andriish-hw/esp32-audio-streamer/hardware/bt internet radio receiver mainboard/source switching.png

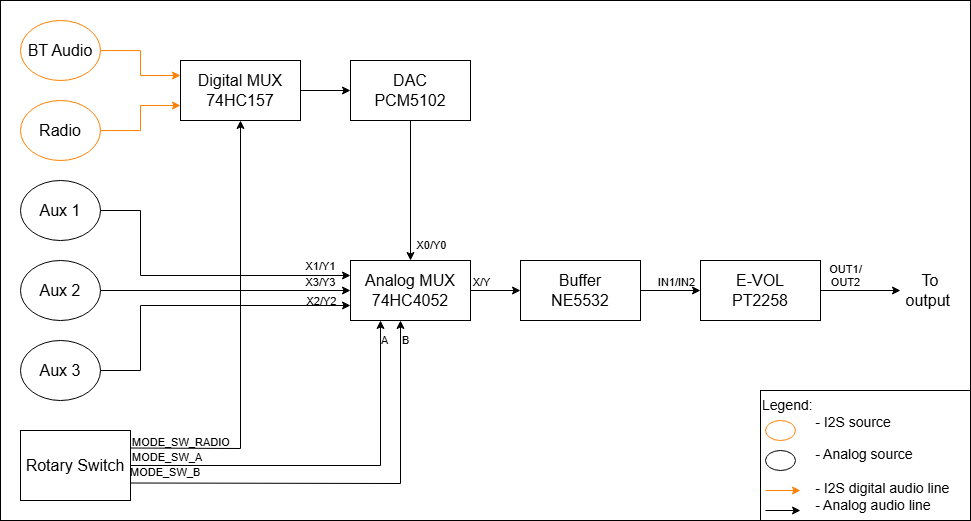
hardware/bt internet radio receiver mainboard/source switching.png
