andriish-hw/esp32-audio-streamer/hardware/bt internet radio receiver audio switch/BOM.xlsx

Reference | Qty | Value | DNP | Exclude from BOM | Exclude from Board | Footprint | Datasheet
*R45,*R46 | 2 | NC | TRUE |  |  | Resistor_SMD:R_0805_2012Metric_Pad1.20x1.40mm_HandSolder | ~
C1,C2,C3,C4,C5,C6,C7,C8 | 8 | 220p | TRUE |  |  | Capacitor_SMD:C_0805_2012Metric_Pad1.18x1.45mm_HandSolder | ~
C9,C10,C20,C21,C22,C23,C25,C26,C33,C42,C43 | 11 | 100n | FALSE |  |  | Capacitor_SMD:C_0805_2012Metric_Pad1.18x1.45mm_HandSolder | ~
C11,C12,C18,C19 | 4 | 100u | FALSE |  |  | Capacitor_THT:CP_Radial_D6.3mm_P2.50mm | ~
C15,C16 | 2 | 150p | TRUE |  |  | Capacitor_SMD:C_0805_2012Metric_Pad1.18x1.45mm_HandSolder | ~
C17,C24 | 2 | 10u | FALSE |  |  | Capacitor_SMD:C_1206_3216Metric_Pad1.33x1.80mm_HandSolder | ~
C27,C28,C29,C30,C31,C32,C34,C35,C36,C37,C38,C39,C40,C41 | 14 | 10u | FALSE |  |  | Capacitor_THT:CP_Radial_D5.0mm_P2.00mm | ~
D1,D2 | 2 | 1N4148 | FALSE |  |  | Diode_SMD:D_SOD-323_HandSoldering | https://assets.nexperia.com/documents/data-sheet/1N4148_1N4448.pdf
D3 | 1 | BZV55C4V3 | TRUE |  |  | Diode_SMD:D_MiniMELF | https://assets.nexperia.com/documents/data-sheet/BZV55_SER.pdf
J1,J4,J7,J9 | 4 | Conn_01x03_Pin | FALSE |  |  | Connector_PinHeader_2.54mm:PinHeader_1x03_P2.54mm_Vertical | ~
J2,J3 | 2 | Conn_Coaxial_x4_Isolated_by_pairs | FALSE |  |  | Connector:KLS1-RCA-410
J5 | 1 | Conn_01x04_Pin | FALSE |  |  | Connector_PinHeader_2.54mm:PinHeader_1x04_P2.54mm_Vertical | ~
J6 | 1 | Conn_01x06_Pin | FALSE |  |  | Connector_PinHeader_2.54mm:PinHeader_1x06_P2.54mm_Vertical | ~
J8,J10 | 2 | Conn_01x05_Pin | FALSE |  |  | Connector_PinHeader_2.54mm:PinHeader_1x05_P2.54mm_Vertical | ~
R1,R19,R20,R44,R45,R47 | 6 | 0 | TRUE |  |  | Resistor_SMD:R_0805_2012Metric_Pad1.20x1.40mm_HandSolder | ~
R2,R46 | 2 | 0 | TRUE |  |  | Resistor_SMD:R_1206_3216Metric_Pad1.30x1.75mm_HandSolder | ~
R3,R4,R7,R8,R11,R12,R15,R16 | 8 | 470 | TRUE |  |  | Resistor_SMD:R_0805_2012Metric_Pad1.20x1.40mm_HandSolder | ~
R5,R6,R9,R10,R13,R14 | 6 | 47k | TRUE |  |  | Resistor_SMD:R_0805_2012Metric_Pad1.20x1.40mm_HandSolder | ~
R17,R18 | 2 | 2.2k | FALSE |  |  | Resistor_SMD:R_0805_2012Metric_Pad1.20x1.40mm_HandSolder | ~
R21,R22,R23,R24,R25,R26,R30,R31,R34,R35,R36,R37,R38,R39 | 14 | 100k | FALSE |  |  | Resistor_SMD:R_0805_2012Metric_Pad1.20x1.40mm_HandSolder | ~
R27,R28 | 2 | 1k | FALSE |  |  | Resistor_SMD:R_0805_2012Metric_Pad1.20x1.40mm_HandSolder | ~
R29 | 1 | 470 | TRUE |  |  | Resistor_SMD:R_1206_3216Metric_Pad1.30x1.75mm_HandSolder | ~
R32,R33 | 2 | 51k | FALSE |  |  | Resistor_SMD:R_0805_2012Metric_Pad1.20x1.40mm_HandSolder | ~
R40,R41 | 2 | 100 | TRUE |  |  | Resistor_SMD:R_0805_2012Metric_Pad1.20x1.40mm_HandSolder | ~
R42,R43 | 2 | 10k | TRUE |  |  | Resistor_SMD:R_0805_2012Metric_Pad1.20x1.40mm_HandSolder | ~
RV1,RV2 | 2 | 47k | FALSE |  |  | Potentiometer_THT:Potentiometer_Runtron_RM-065_Vertical | ~
RV3,RV4 | 2 | 200k | FALSE |  |  | Potentiometer_THT:Potentiometer_Runtron_RM-065_Vertical | ~
U1 | 1 | CD4052B | TRUE |  |  | Package_SO:SOIC-16_3.9x9.9mm_P1.27mm | http://www.ti.com/lit/ds/symlink/cd4052b.pdf
U2,U5,U6 | 3 | NE5532 | FALSE |  |  | Package_DIP:DIP-8_W7.62mm_Socket_LongPads | http://www.ti.com/lit/ds/symlink/ne5532.pdf
U3 | 1 | ISO1540 | FALSE |  |  | Package_SO:SOIC-8_3.9x4.9mm_P1.27mm | http://www.ti.com/lit/ds/symlink/iso1541.pdf
U4 | 1 | PT2258-S | FALSE |  |  | Package_SO:SO-20_12.8x7.5mm_P1.27mm | http://www.princeton.com.tw/Portals/0/Product/PT2258-s.pdf
U7 | 1 | L78L09_TO92 | FALSE |  |  | Package_TO_SOT_THT:TO-92_Inline_Wide | http://www.st.com/content/ccc/resource/technical/document/datasheet/15/55/e5/aa/23/5b/43/fd/CD00000446.pdf/files/CD00000446.pdf/jcr:content/translations/en.CD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
 | 114
 | 41 | 35.96%
