andriish-hw/esp32-audio-streamer/hardware/bt internet radio receiver mainboard/bt internet radio receiver mainboard.pdf

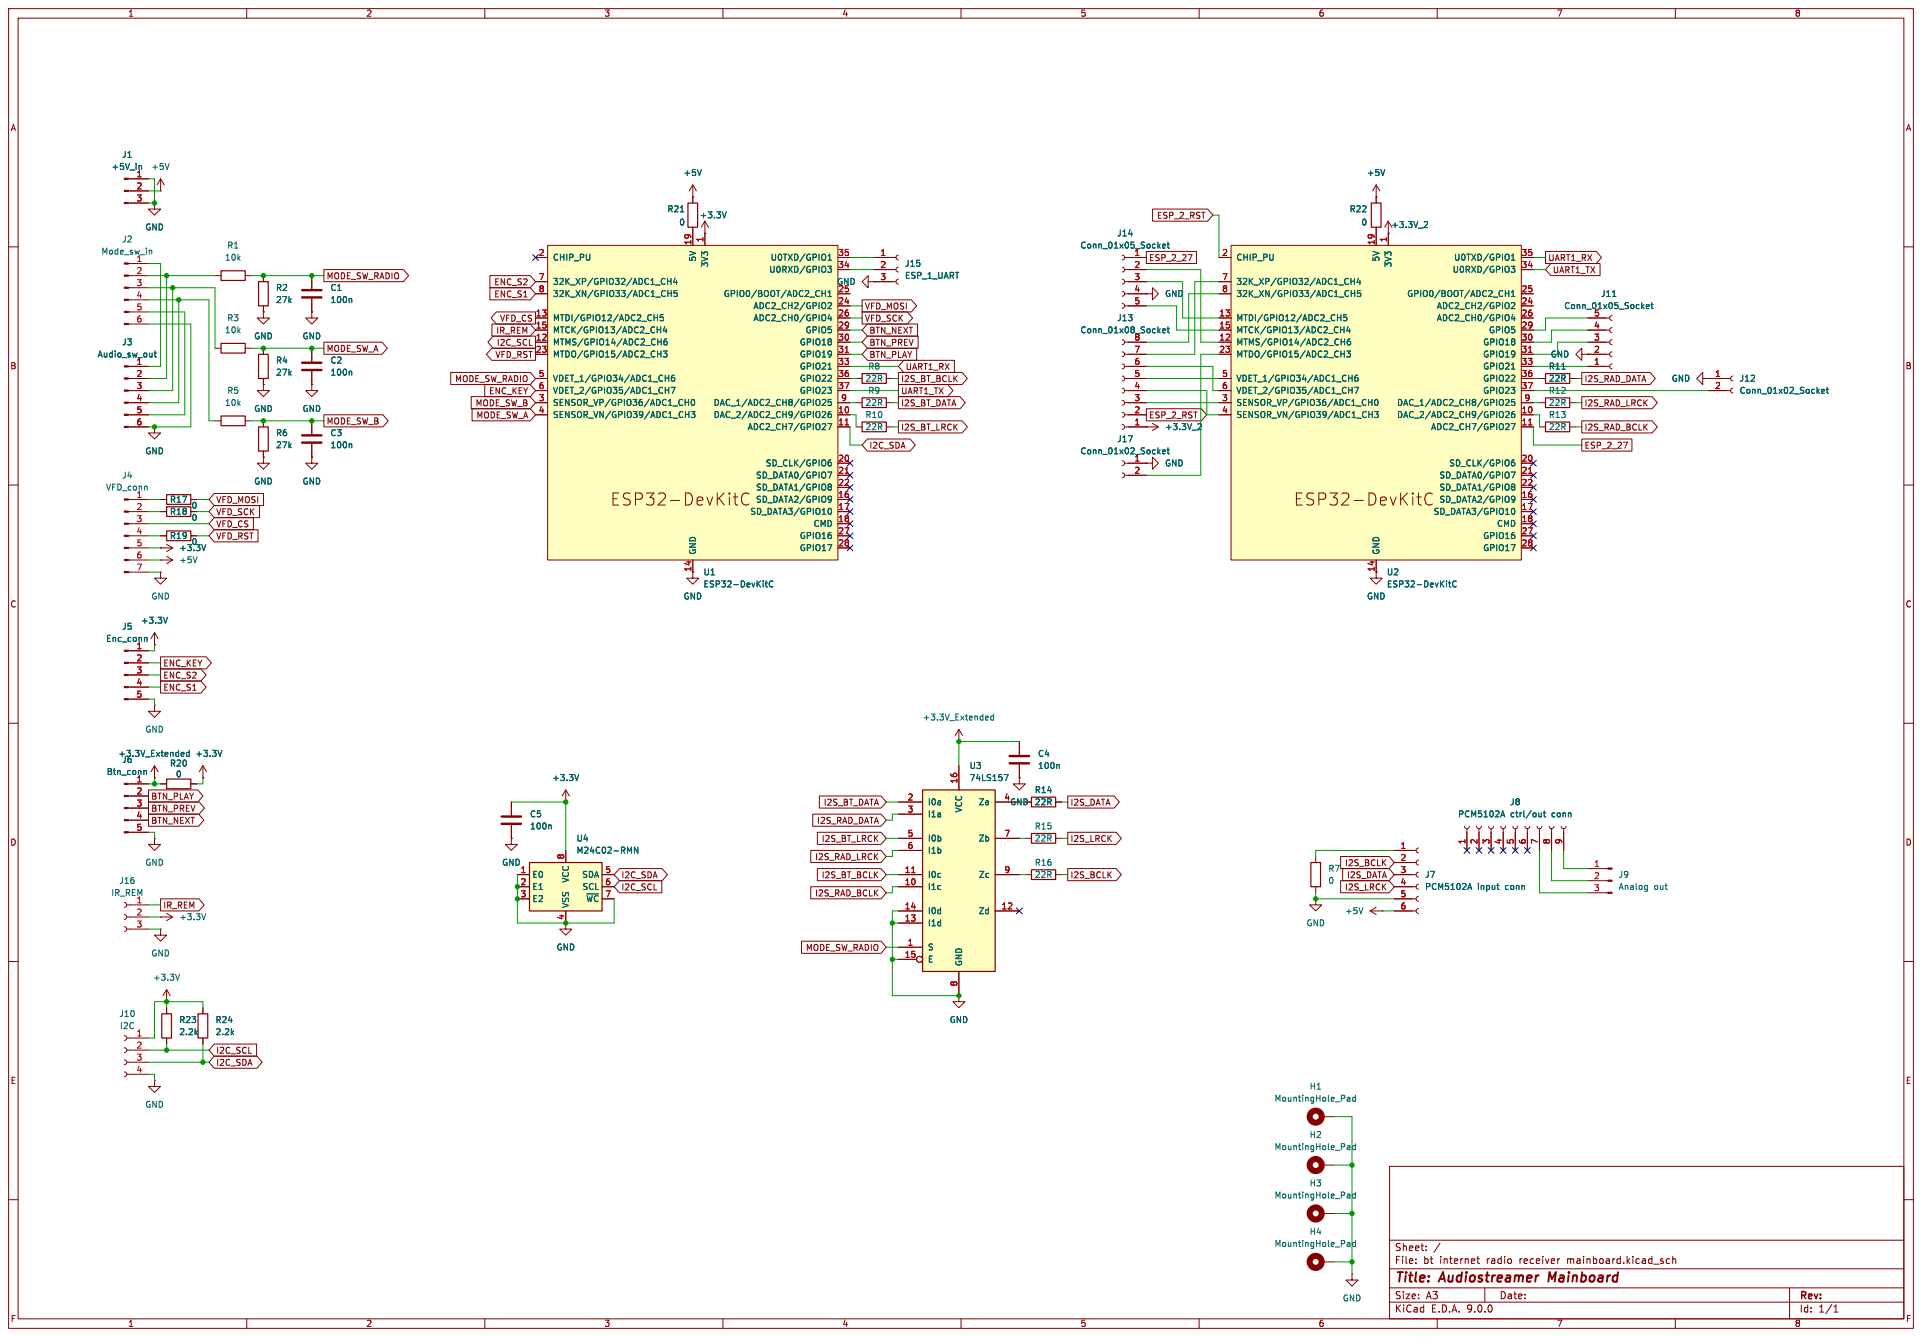
[picture p2: page 1]

4 SDA 5 SCL 6 ~{WC}7 U4 M24C02-RMN GND GND

8 Za 4 Zb 7 Zc 9 Zd 12 GND

Id: 1/1 Title: Audiostreamer Mainboard
