andriish-hw/esp32-audio-streamer/hardware/bt internet radio receiver source rotary switch board/bt internet radio receiver source rotary switch board.pdf

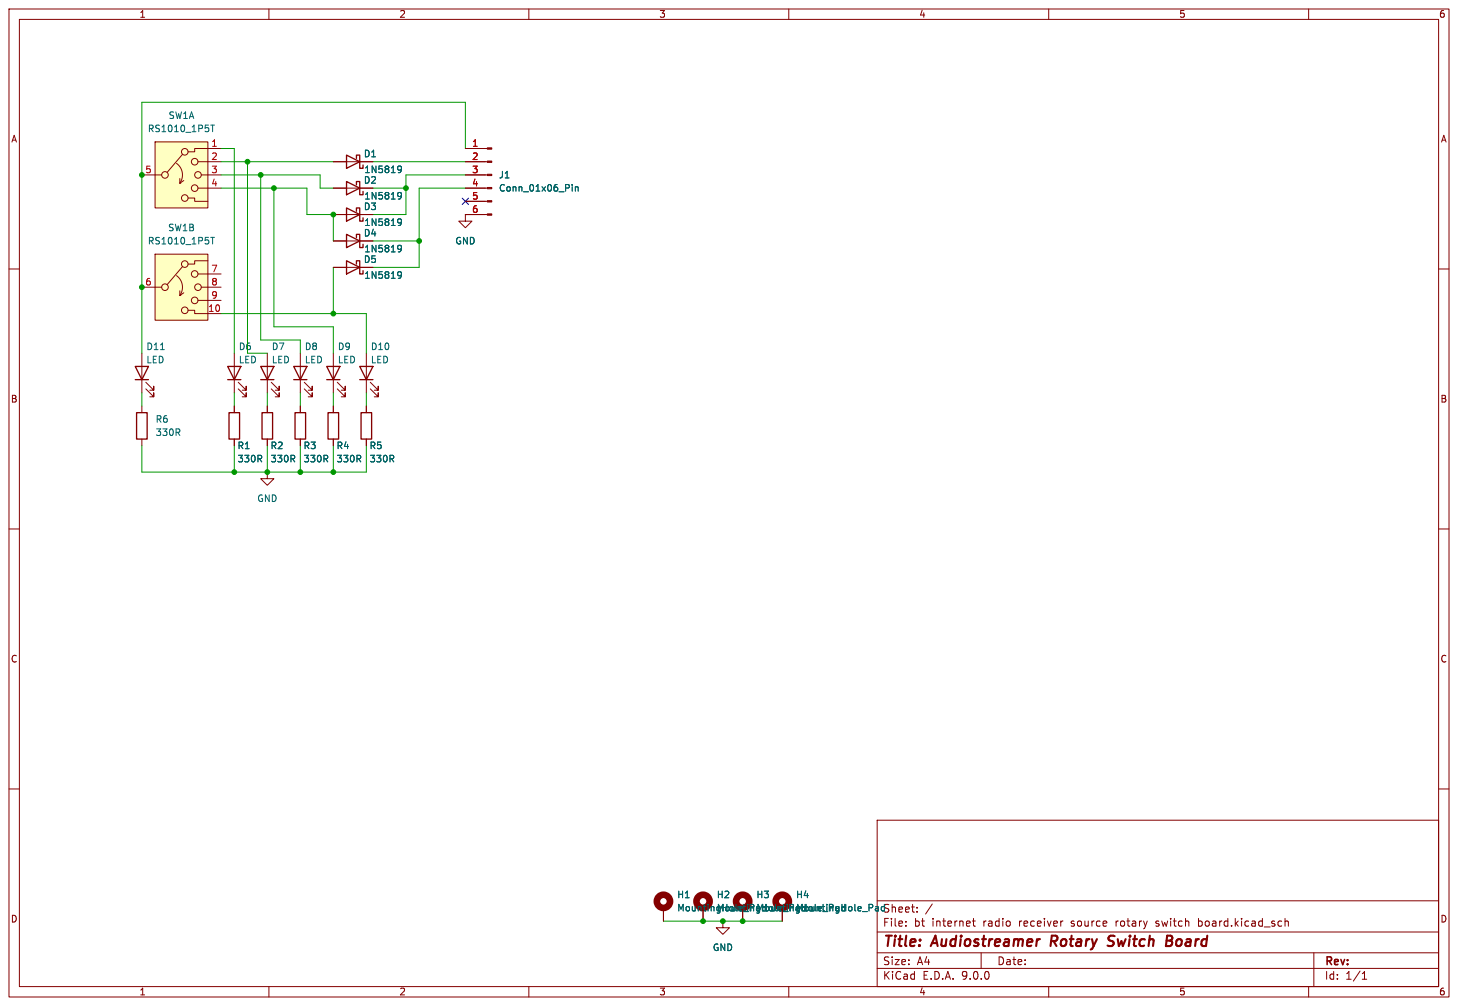
[picture p3: page 1]

Id: 1/1 Title: Audiostreamer Rotary Switch Board
