andriish-hw/esp32-audio-streamer/hardware/opamp headphones amp with discrete transistors/opamp headphones amp with discrete transistors.pdf

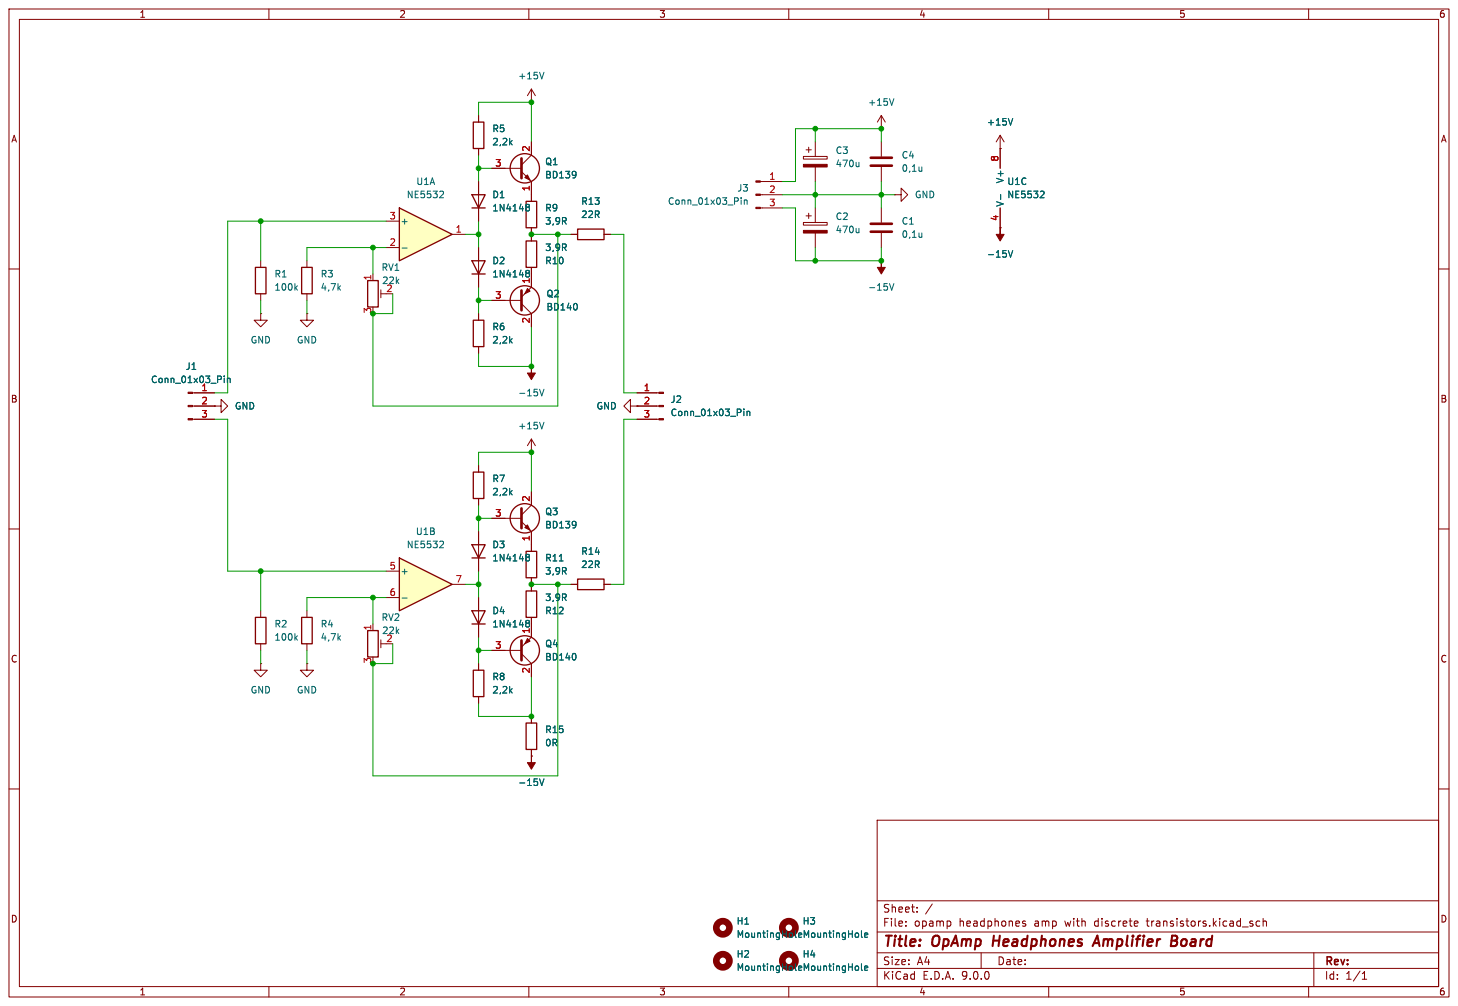
[picture p4: page 1]

H2 MountingHole H4 MountingHole H1 MountingHole H3 MountingHole

Id: 1/1 Title: OpAmp Headphones Amplifier Board
