andriish-hw/esp32-audio-streamer/hardware/VU meter PP4/VU meter PP4.pdf

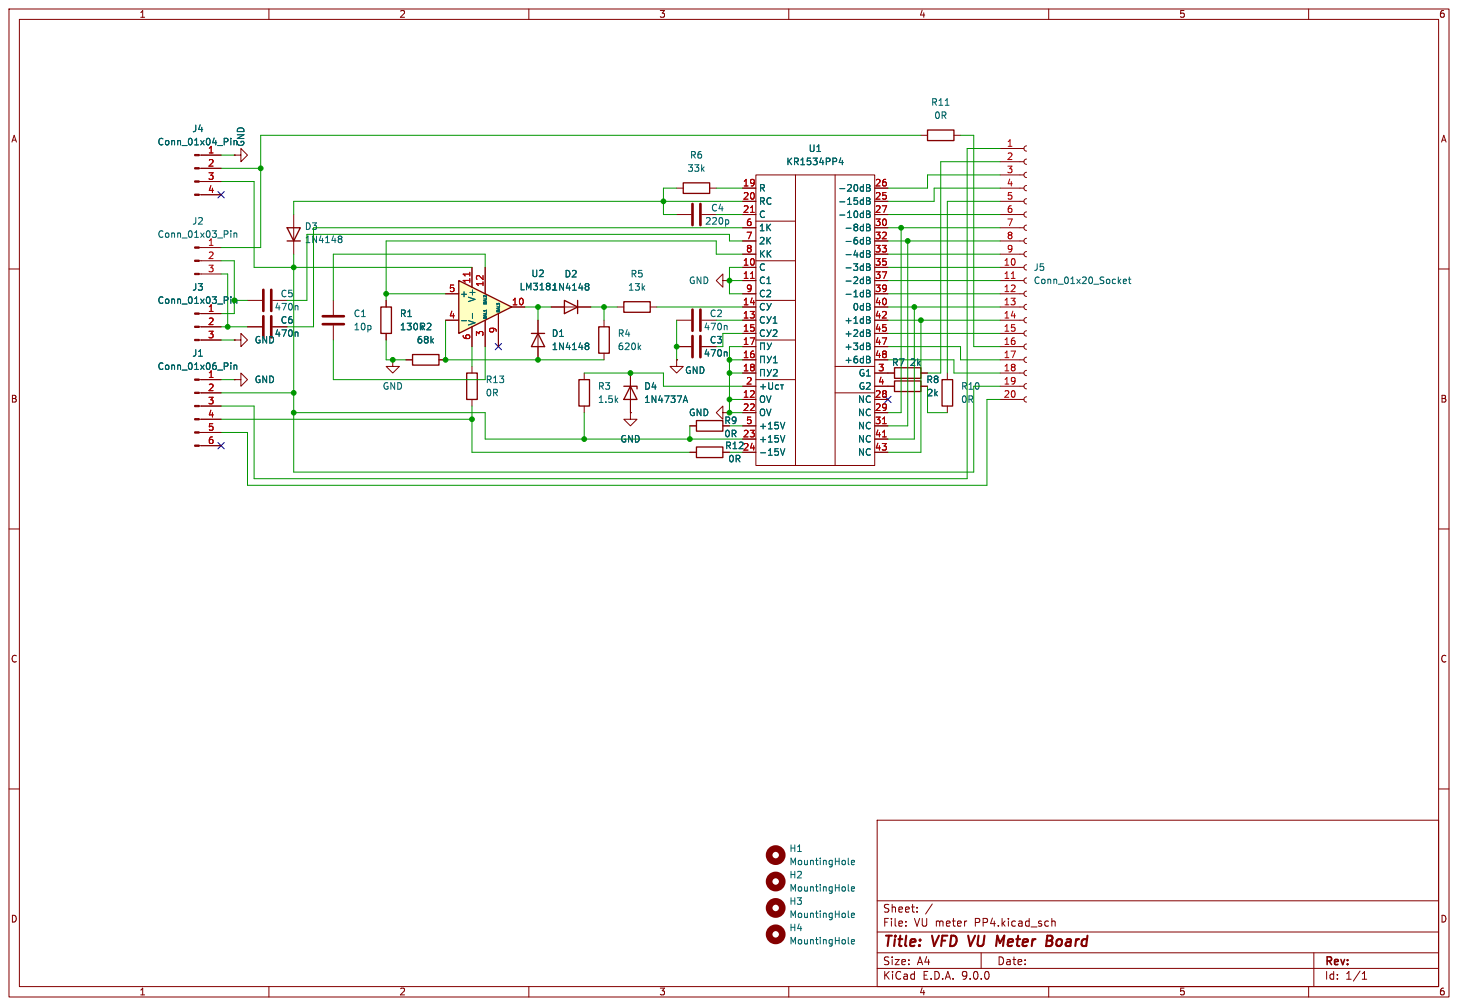
[picture p5: page 1]

H1 MountingHole H4 MountingHole H2 MountingHole H3 MountingHole

Id: 1/1 Title: VFD VU Meter Board
