andriish-hw/esp32-audio-streamer/hardware/bt internet radio receiver audio switch/bt internet radio receiver audio switch.pdf

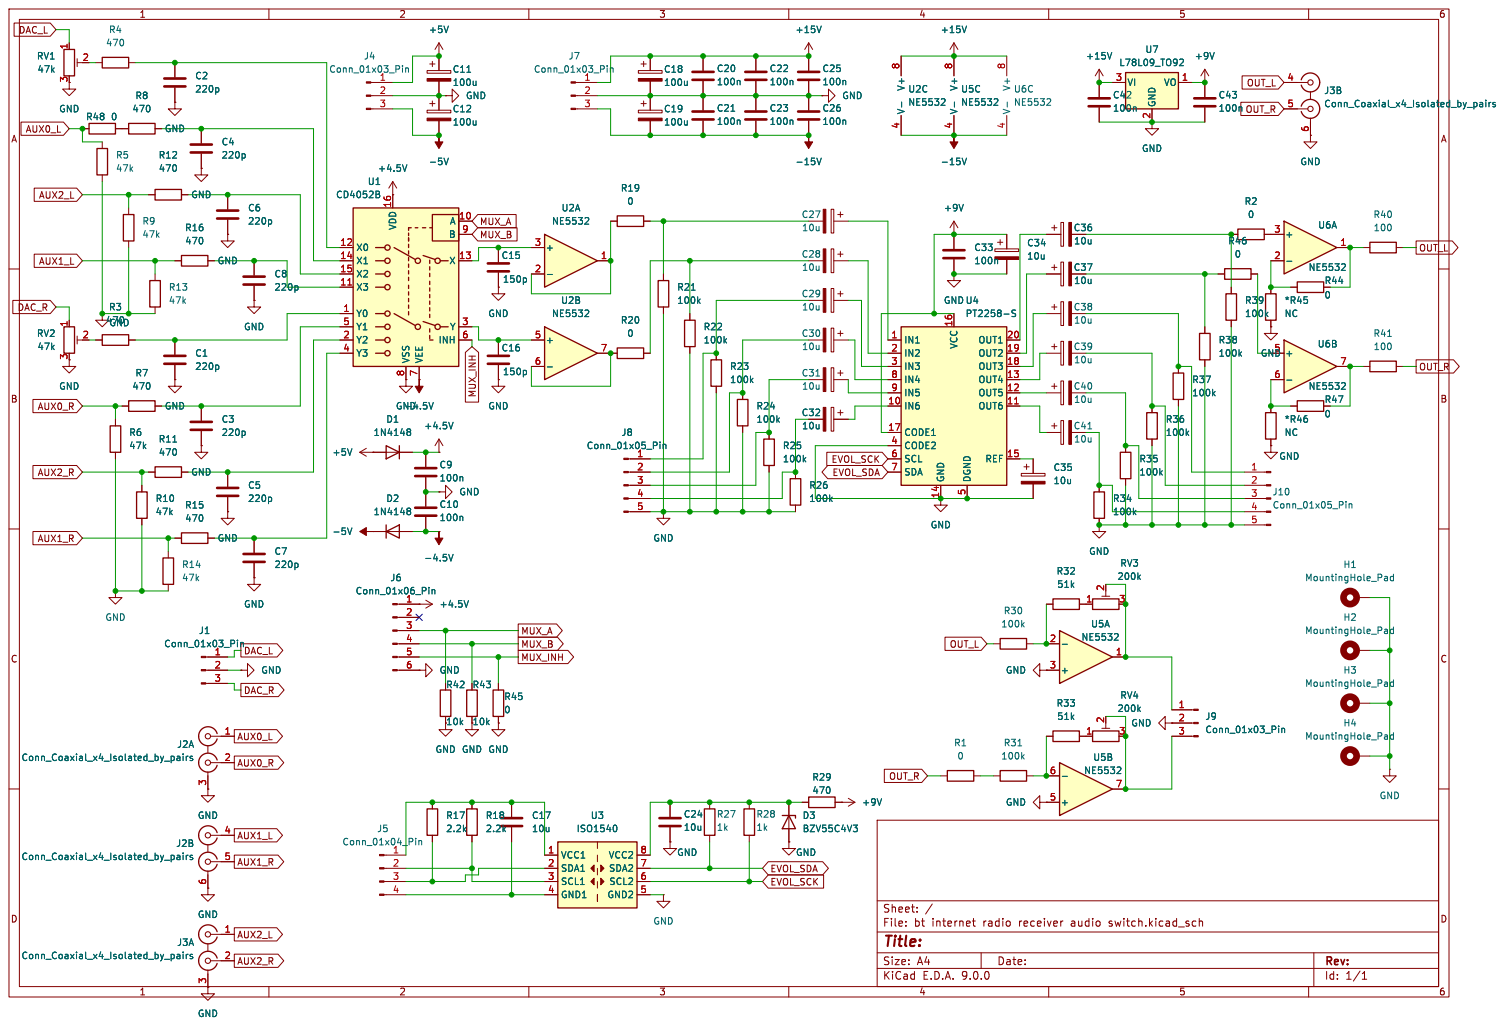
[picture p6: page 1]
