andriish-hw/esp32-audio-streamer/hardware/bt internet radio receiver button board/bt internet radio receiver button board.pdf

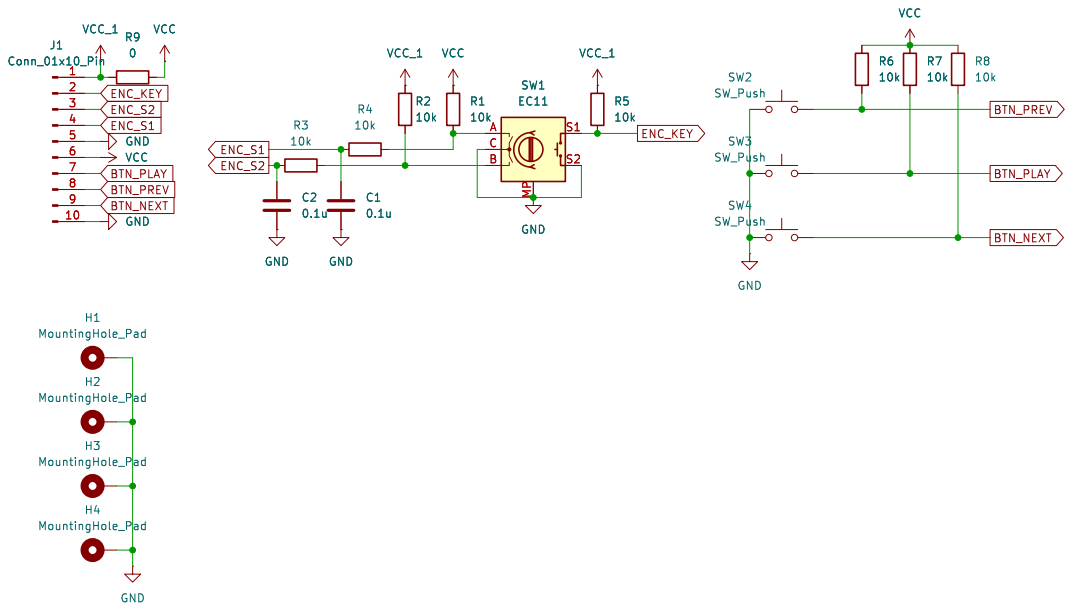
[picture p7: page 1]
