andriish-hw/esp32-audio-streamer/hardware/bt internet radio receiver psu/bt internet radio receiver psu.pdf

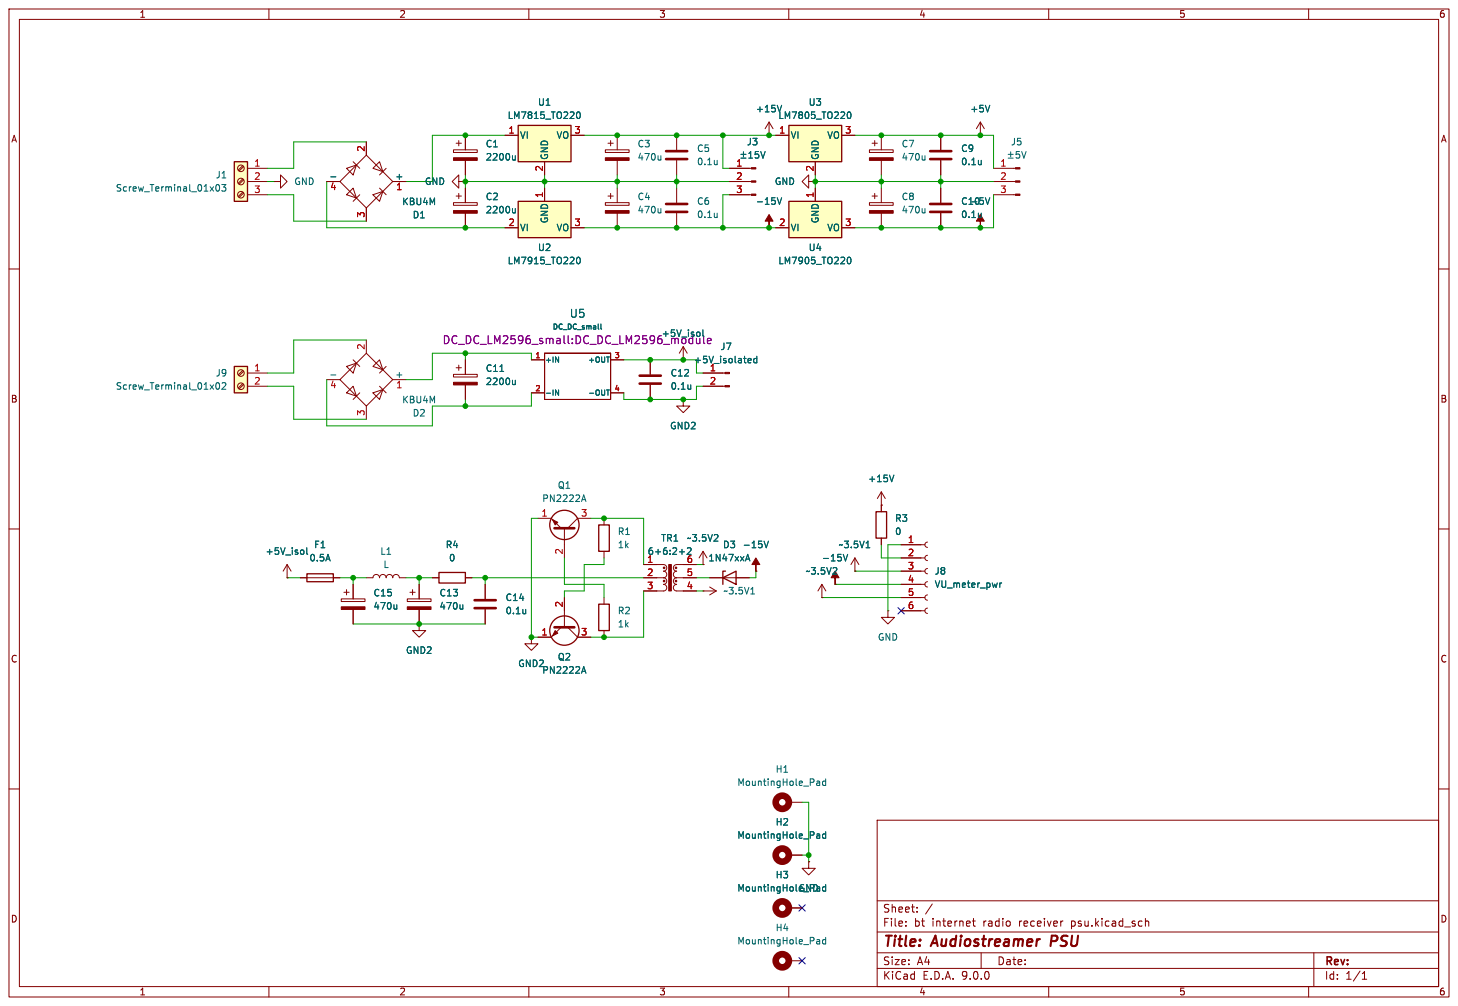
[picture p8: page 1]

Id: 1/1 Title: Audiostreamer PSU
