andriish-hw/esp32-audio-streamer/hardware/bt internet radio receiver audio switch/b.cu.pdf

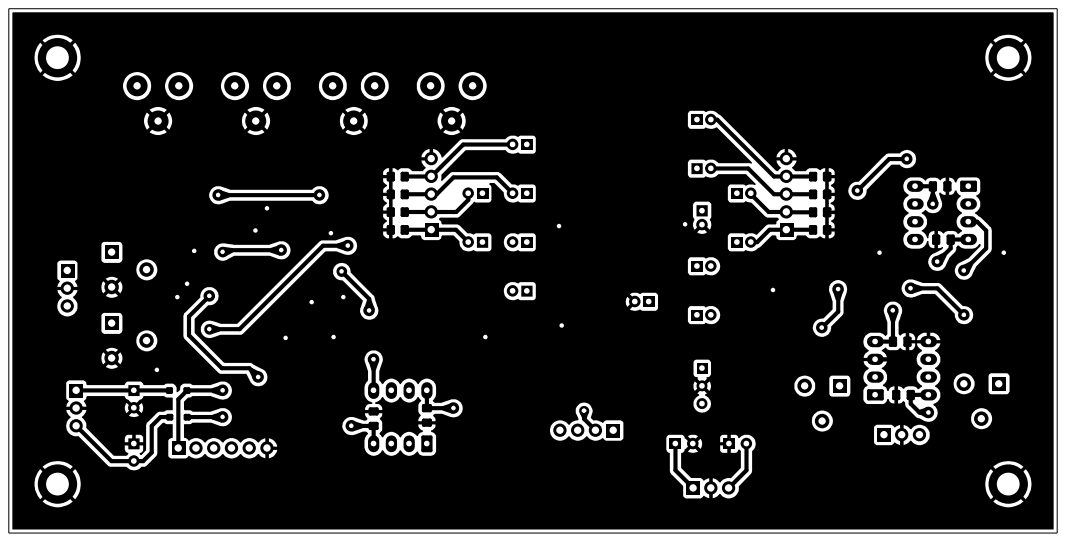
[picture p9: page 1]
