andriish-hw/esp32-audio-streamer/hardware/bt internet radio receiver audio switch/f.cu.pdf

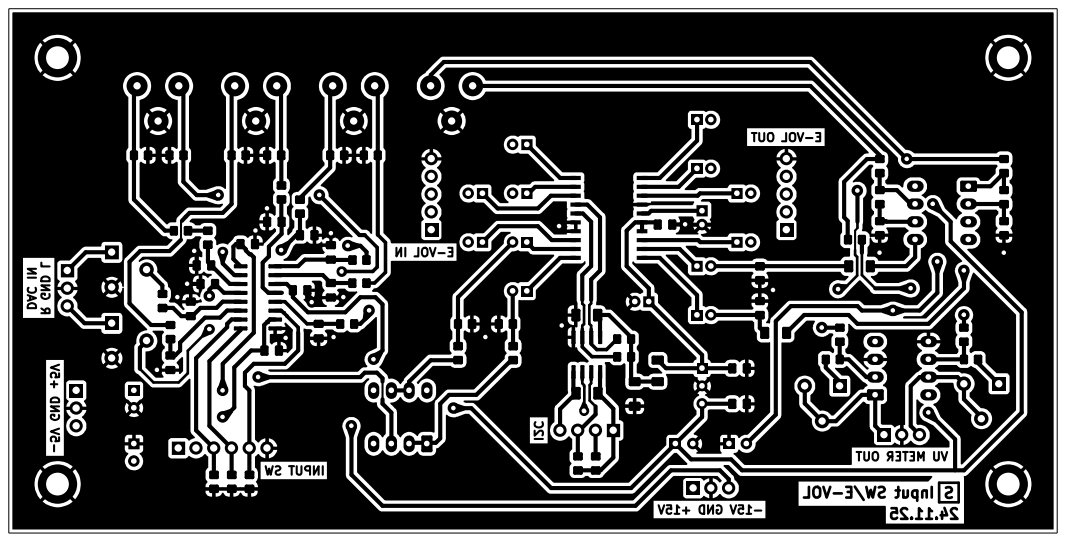
[picture p10: page 1]
