andriish-hw/esp32-audio-streamer/hardware/opamp headphones amp with discrete transistors/opamp headphones amp with discrete transistors 84x60.pdf

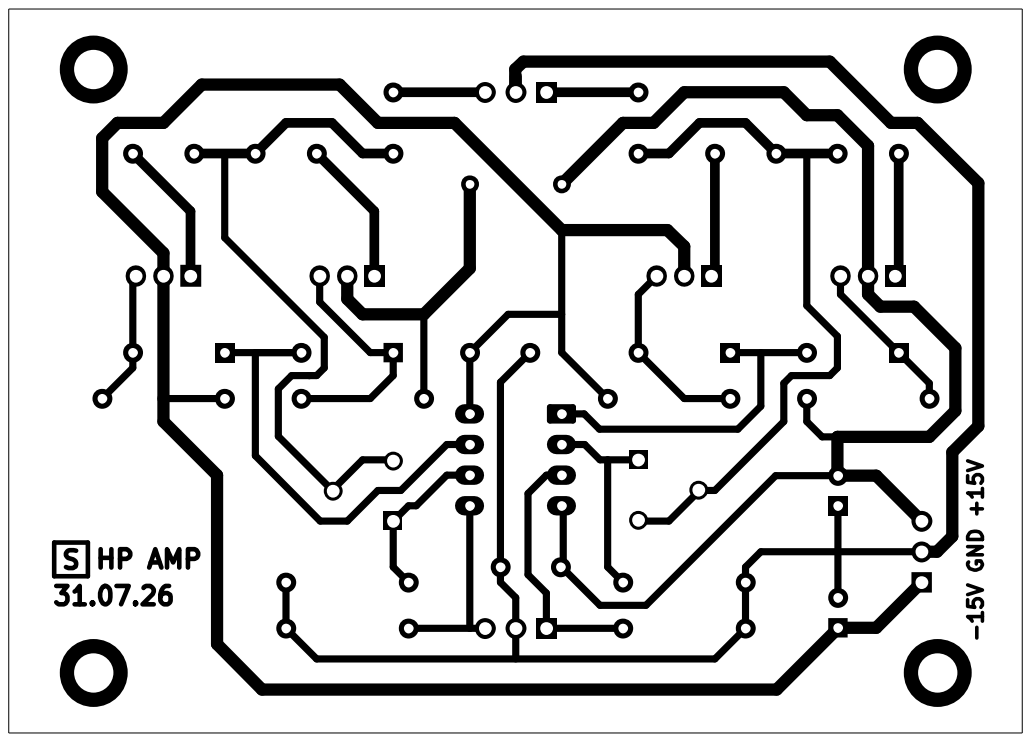
[picture p11: page 1]
