andriish-hw/esp32-audio-streamer/hardware/opamp headphones amp with discrete transistors/дзерк_opamp headphones amp with discrete transistors 84x60.pdf

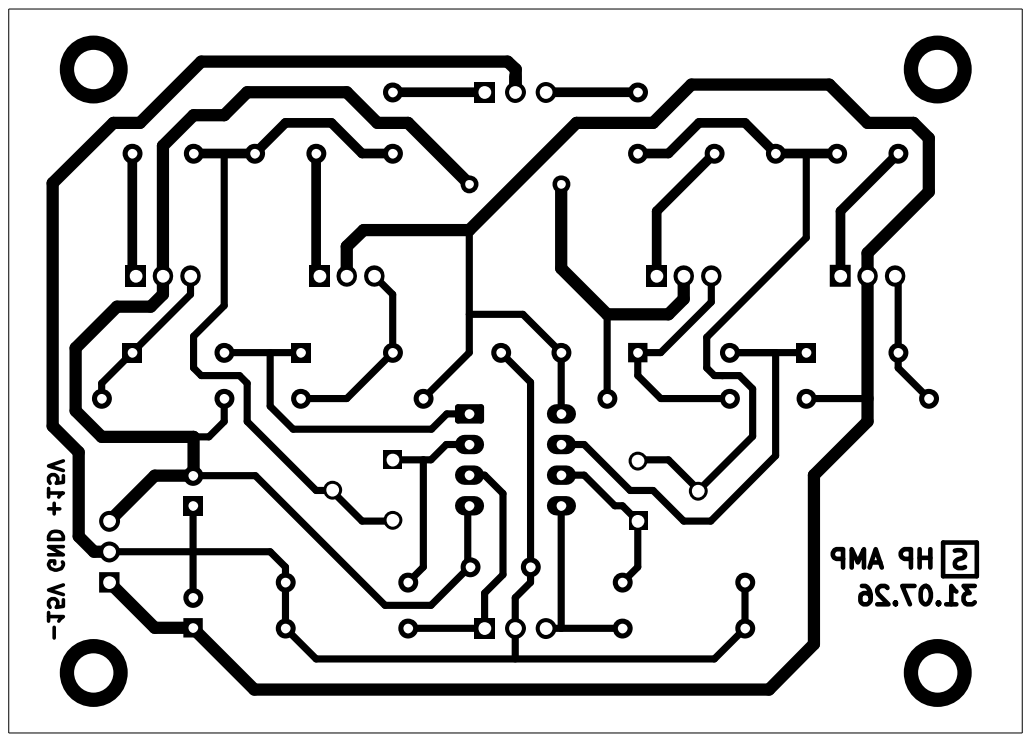
[picture p12: page 1]
