andriish-hw/esp32-audio-streamer/hardware/VU meter PP4/VU meter PP4 100x74.pdf

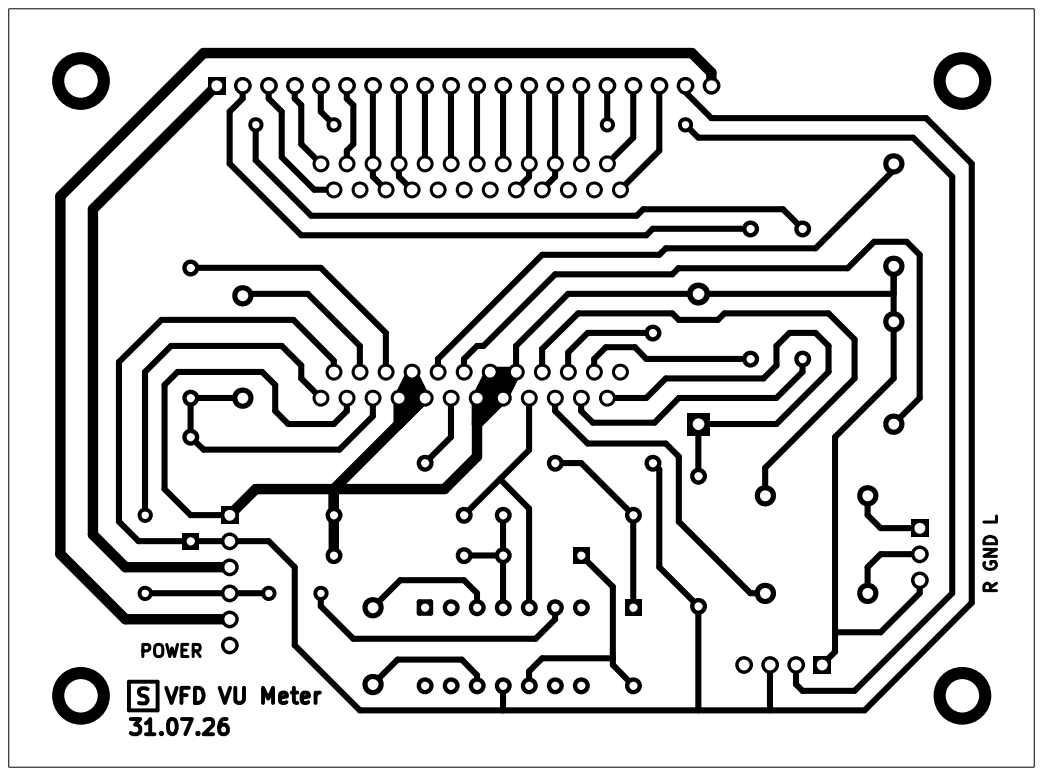
[picture p13: page 1]
