andriish-hw/esp32-audio-streamer/hardware/VU meter PP4/дзерк_VU meter PP4 100x74.pdf

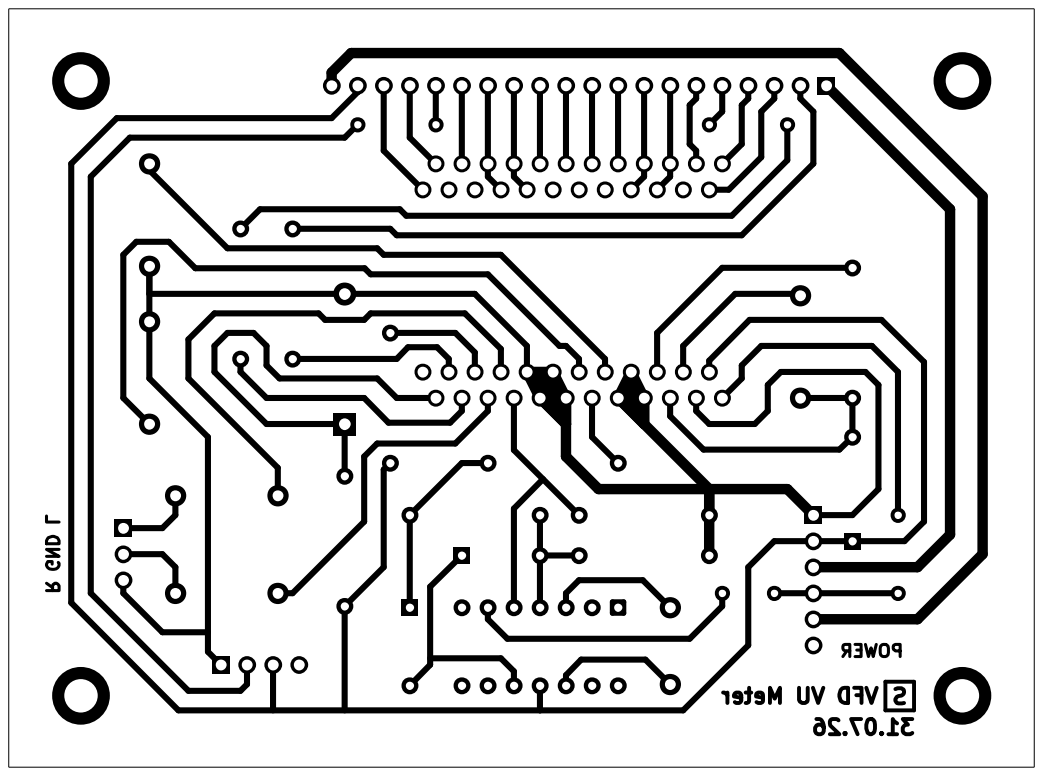
[picture p14: page 1]
