andriish-hw/esp32-audio-streamer/(list of files, drawings)

Other design files:
hardware/bt internet radio receiver audio switch/freerouting.dsn
hardware/bt internet radio receiver audio switch/temp-freerouting.dsn
