andriish-hw/esp32-audio-streamer/hardware/bt internet radio receiver audio switch/bt internet radio receiver audio switch.kicad_pcb

## KiCad design hardware/bt internet radio receiver audio switch/bt internet radio receiver audio switch.kicad_pcb (2026-08-18)

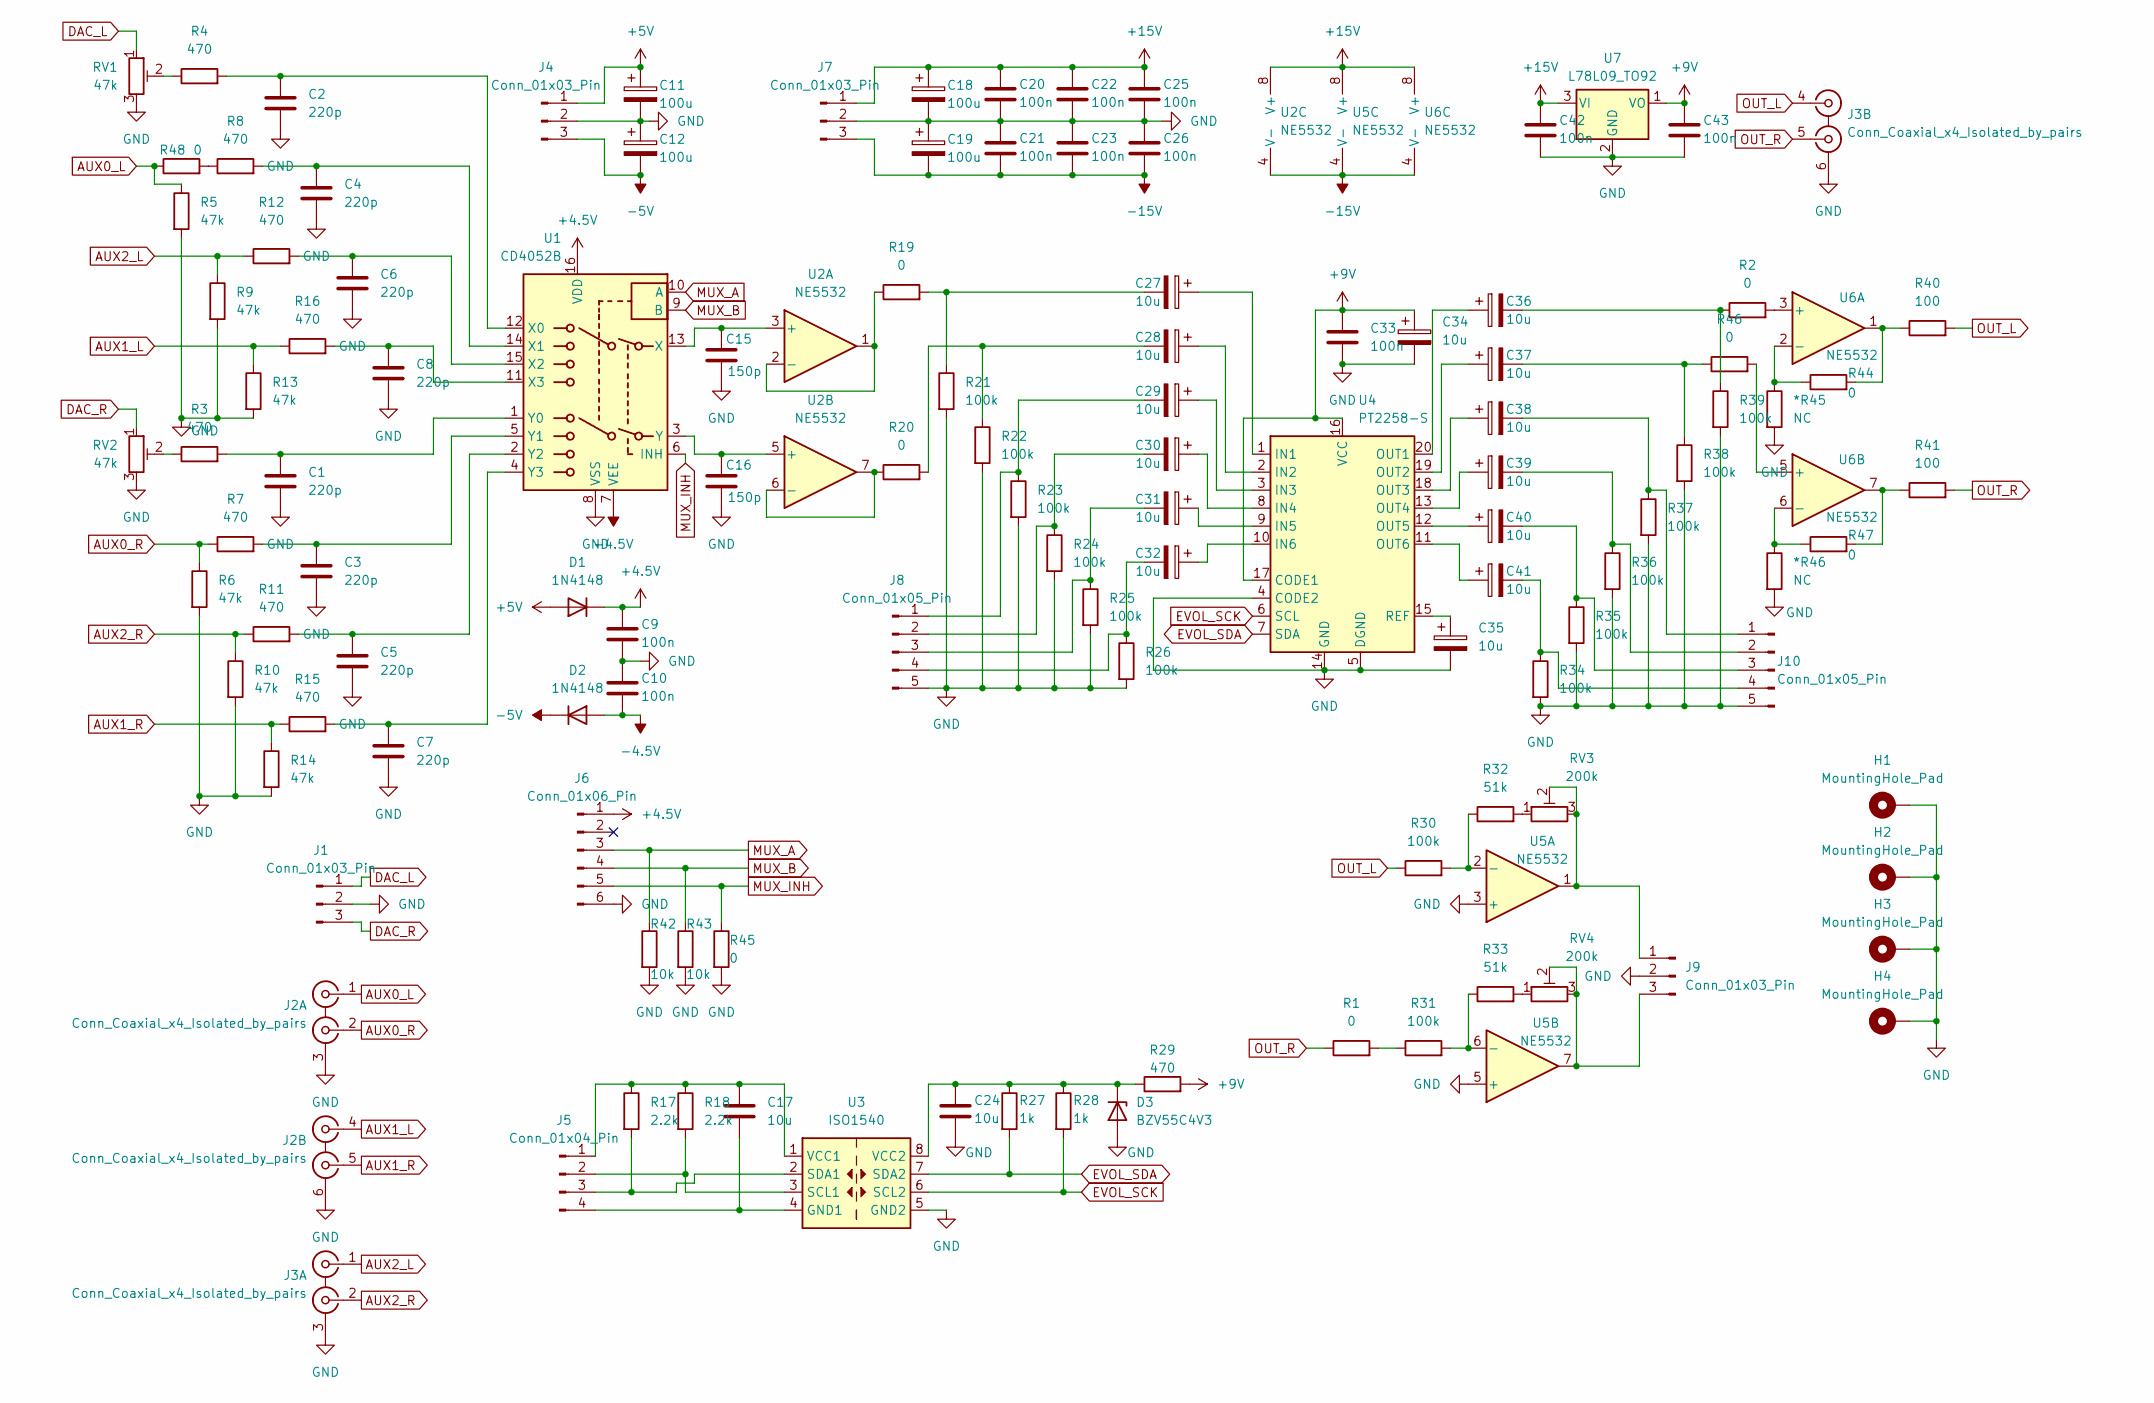
[picture p15: schematic bt internet radio receiver audio switch.kicad_sch]

Parts:
*R45, *R46: NC; R_0805_2012Metric_Pad1.20x1.40mm_HandSolder
C1, C2, C3, C4, C5, C6, C7, C8: 220p; C_0805_2012Metric_Pad1.18x1.45mm_HandSolder
C9, C10, C20, C21, C22, C23, C25, C26, C33, C42, C43: 100n; C_0805_2012Metric_Pad1.18x1.45mm_HandSolder
C11, C12, C18, C19: 100u; CP_Radial_D6.3mm_P2.50mm
C15, C16: 150p; C_0805_2012Metric_Pad1.18x1.45mm_HandSolder
C17, C24: 10u; C_1206_3216Metric_Pad1.33x1.80mm_HandSolder
C27, C28, C29, C30, C31, C32, C34, C35, C36, C37, C38, C39, C40, C41: 10u; CP_Radial_D5.0mm_P2.00mm
D1, D2: 1N4148; D_SOD-323_HandSoldering
D3: BZV55C4V3; D_MiniMELF
H1, H2, H3, H4: MountingHole_Pad; MountingHole_3.2mm_M3_DIN965_Pad_TopBottom
J1, J4, J7, J9: Conn_01x03_Pin; PinHeader_1x03_P2.54mm_Vertical
J2, J3: Conn_Coaxial_x4_Isolated_by_pairs; KLS1-RCA-410
J5: Conn_01x04_Pin; PinHeader_1x04_P2.54mm_Vertical
J6: Conn_01x06_Pin; PinHeader_1x06_P2.54mm_Vertical
J8, J10: Conn_01x05_Pin; PinHeader_1x05_P2.54mm_Vertical
R1, R19, R20, R44, R45, R47, R48: 0; R_0805_2012Metric_Pad1.20x1.40mm_HandSolder
R2, R46: 0; R_1206_3216Metric_Pad1.30x1.75mm_HandSolder
R3, R4, R7, R8, R11, R12, R15, R16: 470; R_0805_2012Metric_Pad1.20x1.40mm_HandSolder
R5, R6, R9, R10, R13, R14: 47k; R_0805_2012Metric_Pad1.20x1.40mm_HandSolder
R17, R18: 2.2k; R_0805_2012Metric_Pad1.20x1.40mm_HandSolder
R21, R22, R23, R24, R25, R26, R30, R31, R34, R35, R36, R37, R38, R39: 100k; R_0805_2012Metric_Pad1.20x1.40mm_HandSolder
R27, R28: 1k; R_0805_2012Metric_Pad1.20x1.40mm_HandSolder
R29: 470; R_1206_3216Metric_Pad1.30x1.75mm_HandSolder
R32, R33: 51k; R_0805_2012Metric_Pad1.20x1.40mm_HandSolder
R40, R41: 100; R_0805_2012Metric_Pad1.20x1.40mm_HandSolder
R42, R43: 10k; R_0805_2012Metric_Pad1.20x1.40mm_HandSolder
RV1, RV2: 47k; Potentiometer_Runtron_RM-065_Vertical
RV3, RV4: 200k; Potentiometer_Runtron_RM-065_Vertical
U1: CD4052B; SOIC-16_3.9x9.9mm_P1.27mm
U2, U5, U6: NE5532; DIP-8_W7.62mm_Socket_LongPads
U3: ISO1540; SOIC-8_3.9x4.9mm_P1.27mm
U4: PT2258-S; SO-20_12.8x7.5mm_P1.27mm
U7: L78L09_TO92; TO-92_Inline_Wide

Connections:
+4.5V: C9.1, D1.1 (K), J6.1, U1.16 (VDD)
+5V: C11.1, D1.2 (A), J4.1
+9V: C33.1, C34.1, C43.1, R29.2, U4.16 (VCC), U4.17 (CODE1), U7.1 (VO)
+15V: C18.1, C20.1, C22.1, C25.1, C42.1, J7.1, U2.8 (V+), U5.8 (V+), U6.8 (V+), U7.3 (VI)
-4.5V: C10.2, D2.2 (A), U1.7 (VEE)
-5V: C12.2, D2.1 (K), J4.3
-15V: C19.2, C21.2, C23.2, C26.2, J7.3, U2.4 (V-), U5.4 (V-), U6.4 (V-)
AUX0_L: J2.1 (IN1), R5.1, R48.1
AUX0_R: J2.2 (IN2), R6.1, R7.1
AUX1_L: J2.4 (IN1), R13.1, R16.1
AUX1_R: J2.5 (IN2), R14.1, R15.1
AUX2_L: J3.1 (IN1), R9.1, R12.1
AUX2_R: J3.2 (IN2), R10.1, R11.1
DAC_L: J1.1, RV1.1
DAC_R: J1.3, RV2.1
EVOL_SCK: R28.2, U3.6 (SCL2), U4.6 (SCL)
EVOL_SDA: R27.2, U3.7 (SDA2), U4.7 (SDA)
GND: *R45.2, *R46.2, C1.2, C2.2, C3.2, C4.2, C5.2, C6.2, C7.2, C8.2, C9.2, C10.1, C11.2, C12.1, C15.2, C16.2, C18.2, C19.1, C20.2, C21.1, C22.2, C23.1, C24.2, C25.2, C26.1, C33.2, C34.2, C35.2, C42.2, C43.2, D3.2 (A), H1.1, H2.1, H3.1, H4.1, J1.2, J2.3 (EXT), J2.6 (EXT), J3.3 (EXT), J3.6 (EXT), J4.2, J6.6, J7.2, J8.5, J9.2, J10.5, R5.2, R6.2, R9.2, R10.2, R13.2, R14.2, R21.2, R22.2, R23.2, R24.2, R25.2, R26.2, R34.2, R35.2, R36.2, R37.2, R38.2, R39.2, R42.2, R43.2, R45.2, RV1.3, RV2.3, U1.8 (VSS), U3.5 (GND2), U4.4 (CODE2), U4.5 (DGND), U4.14 (GND), U5.3 (+), U5.5 (+), U7.2 (GND)
MUX_A: J6.3, R42.1, U1.10 (A)
MUX_B: J6.4, R43.1, U1.9 (B)
MUX_INH: J6.5, R45.1, U1.6 (INH)
unnamed: C27.2, R19.2, R21.1
unnamed: C28.2, R20.2, R22.1
unnamed: C36.2, R2.1, R39.1
unnamed: C37.2, R38.1, R46.1
unnamed: C24.1, D3.1 (K), R27.1, R28.1, R29.1, U3.8 (VCC2)
unnamed: C17.1, J5.1, R17.1, R18.1, U3.1 (VCC1)
unnamed: J5.2, R18.2, U3.3 (SCL1)
unnamed: J5.3, R17.2, U3.2 (SDA1)
unnamed: C17.2, J5.4, U3.4 (GND1)
unnamed: C29.2, J8.1, R23.1
unnamed: C30.2, J8.2, R24.1
unnamed: C31.2, J8.3, R25.1
unnamed: C32.2, J8.4, R26.1
unnamed: J9.1, RV3.2, RV3.3, U5.1
unnamed: J9.3, RV4.2, RV4.3, U5.7
unnamed: C38.2, J10.1, R37.1
unnamed: C39.2, J10.2, R36.1
unnamed: C40.2, J10.3, R35.1
unnamed: C41.2, J10.4, R34.1
unnamed: R1.2, R31.1
unnamed: R3.1, RV2.2
unnamed: R4.1, RV1.2
unnamed: R32.2, RV3.1
unnamed: R33.2, RV4.1
unnamed: R40.1, R44.2, U6.1
unnamed: R41.1, R47.2, U6.7
unnamed: R8.1, R48.2
unnamed: C2.1, R4.2, U1.12 (X0)
unnamed: C4.1, R8.2, U1.14 (X1)
unnamed: C6.1, R12.2, U1.15 (X2)
unnamed: C8.1, R16.2, U1.11 (X3)
unnamed: C15.1, U1.13 (X), U2.3 (+)
unnamed: C1.1, R3.2, U1.1 (Y0)
unnamed: C3.1, R7.2, U1.5 (Y1)
unnamed: C5.1, R11.2, U1.2 (Y2)
unnamed: C7.1, R15.2, U1.4 (Y3)
unnamed: C16.1, U1.3 (Y), U2.5 (+)
unnamed: R19.1, U2.1, U2.2 (-)
unnamed: R20.1, U2.6 (-), U2.7
unnamed: C27.1, U4.1 (IN1)
unnamed: C28.1, U4.2 (IN2)
unnamed: C29.1, U4.3 (IN3)
unnamed: C30.1, U4.8 (IN4)
unnamed: C31.1, U4.9 (IN5)
unnamed: C32.1, U4.10 (IN6)
unnamed: C36.1, U4.20 (OUT1)
unnamed: C37.1, U4.19 (OUT2)
unnamed: C38.1, U4.18 (OUT3)
unnamed: C39.1, U4.13 (OUT4)
unnamed: C40.1, U4.12 (OUT5)
unnamed: C41.1, U4.11 (OUT6)
unnamed: C35.1, U4.15 (REF)
unnamed: R30.2, R32.1, U5.2 (-)
unnamed: R31.2, R33.1, U5.6 (-)
unnamed: R2.2, U6.3 (+)
unnamed: *R45.1, R44.1, U6.2 (-)
unnamed: R46.2, U6.5 (+)
unnamed: *R46.1, R47.1, U6.6 (-)
OUT_L: J3.4 (IN1), R30.1, R40.2
OUT_R: J3.5 (IN2), R1.1, R41.2

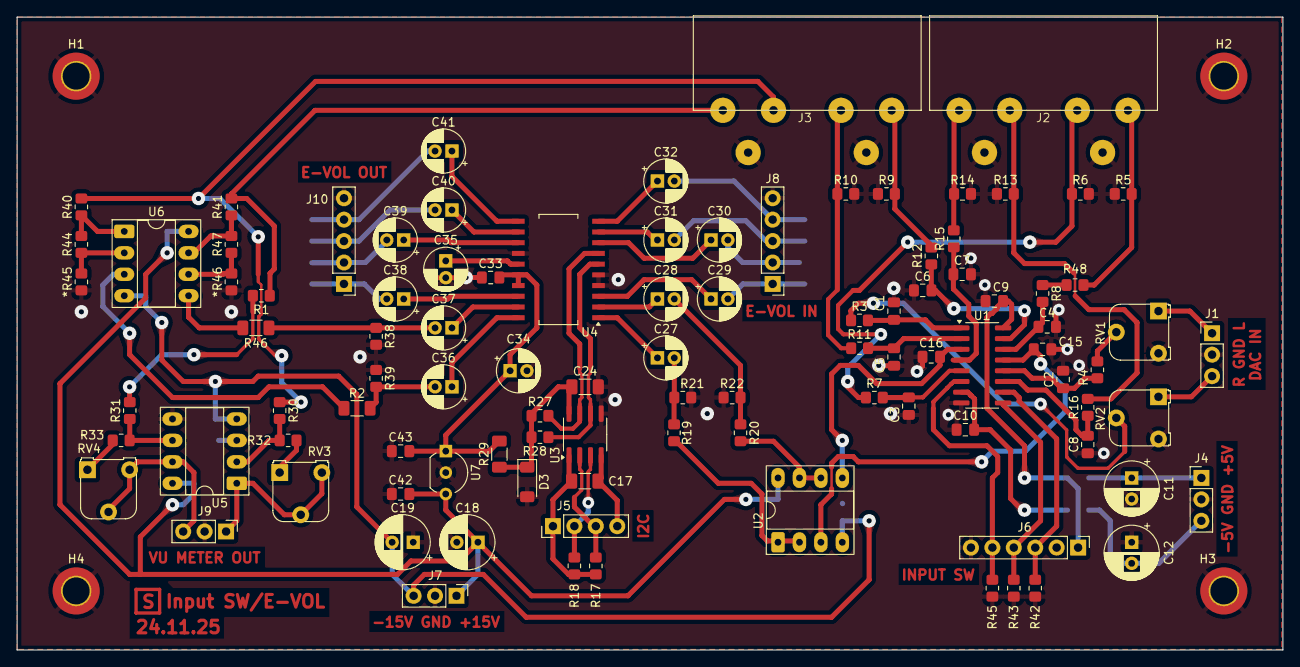
[picture p16: board bt internet radio receiver audio switch.kicad_pcb from above]

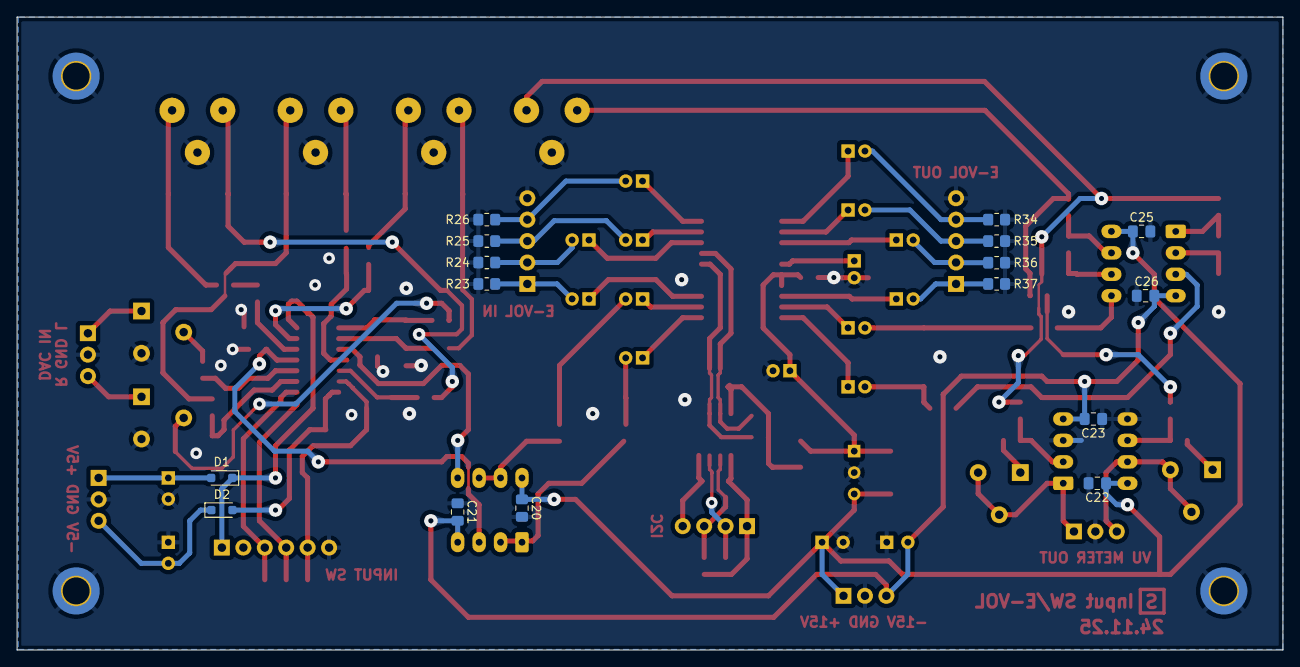
[picture p17: board bt internet radio receiver audio switch.kicad_pcb from below]

Board: 2 copper layers, 150.0 x 75.0 mm, 119 parts (16 on the bottom side), 81 nets.
