andriish-hw/esp32-audio-streamer/hardware/bt internet radio receiver button board/bt internet radio receiver button board.kicad_pcb

## KiCad design hardware/bt internet radio receiver button board/bt internet radio receiver button board.kicad_pcb (2026-08-18)

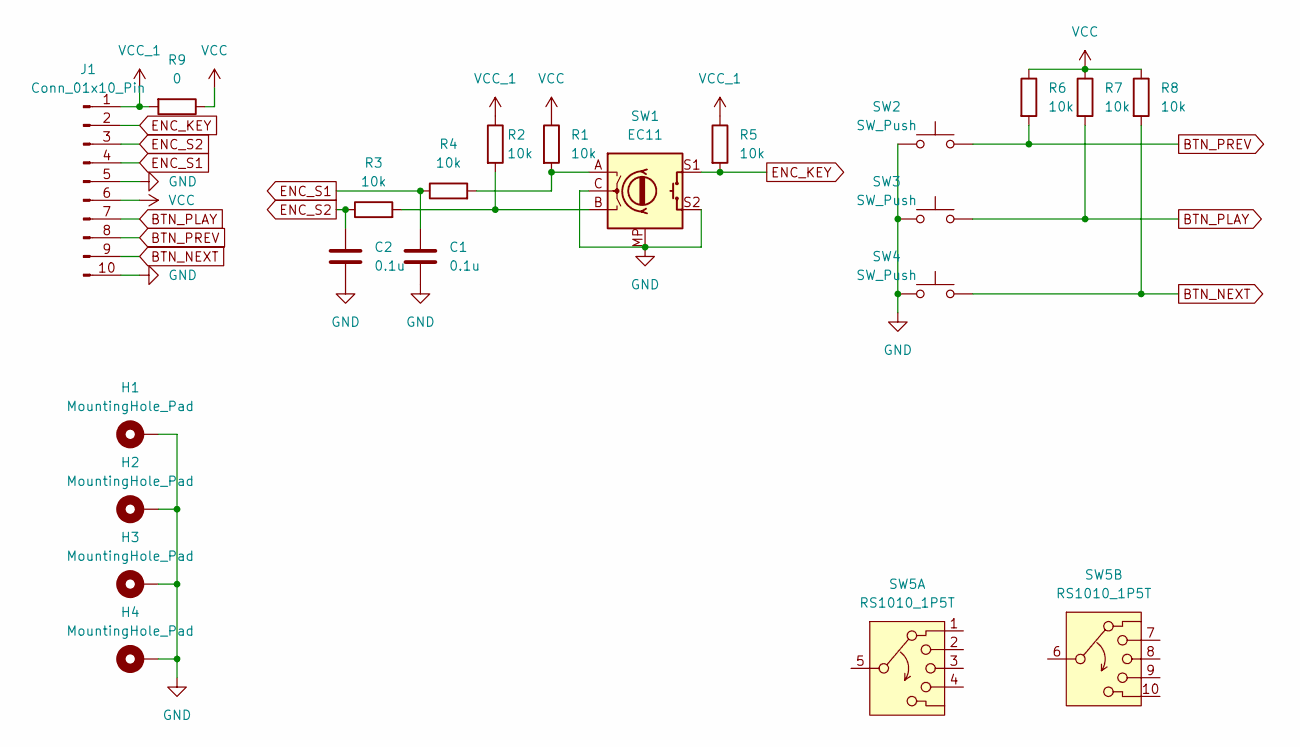
[picture p18: schematic bt internet radio receiver button board.kicad_sch]

Parts:
C1, C2: 0.1u; C_0805_2012Metric_Pad1.18x1.45mm_HandSolder
H1, H2, H3, H4: MountingHole_Pad; MountingHole_3.2mm_M3_Pad_TopBottom
J1: Conn_01x10_Pin; PinHeader_1x10_P2.54mm_Horizontal
R1, R2, R3, R4, R5, R6, R7, R8: 10k; R_0805_2012Metric_Pad1.20x1.40mm_HandSolder
R9: 0; R_Axial_DIN0204_L3.6mm_D1.6mm_P7.62mm_Horizontal
SW1: EC11; RotaryEncoder_Alps_EC11E-Switch_Vertical_H20mm
SW2, SW3, SW4: SW_Push; SW_PUSH_6mm
SW5: RS1010_1P5T

Connections:
BTN_NEXT: J1.9, R8.2, SW4.1
BTN_PLAY: J1.7, R7.2, SW3.1
BTN_PREV: J1.8, R6.2, SW2.1
ENC_KEY: J1.2, R5.2, SW1.S1
ENC_S1: C1.1, J1.4, R4.1
ENC_S2: C2.1, J1.3, R3.1
GND: C1.2, C2.2, H1.1, H2.1, H3.1, H4.1, J1.5, J1.10, SW1.C, SW1.MP, SW1.S2, SW2.2, SW3.2, SW4.2
unnamed: R1.2, R4.2, SW1.A
unnamed: R2.2, R3.2, SW1.B
VCC: J1.6, R1.1, R6.1, R7.1, R8.1, R9.1
VCC_1: J1.1, R2.1, R5.1, R9.2

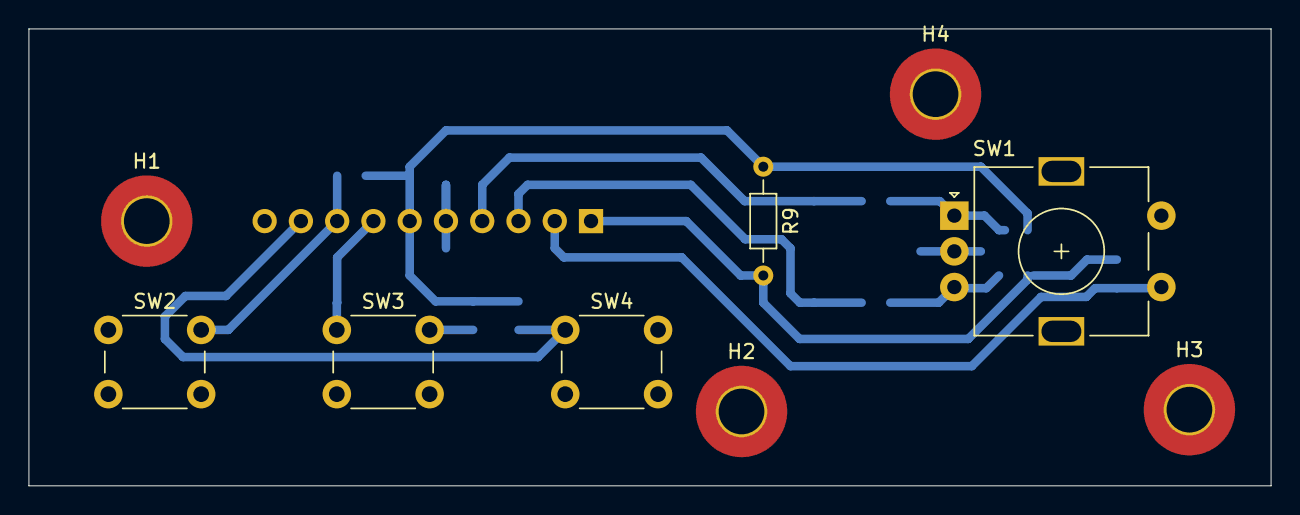
[picture p19: board bt internet radio receiver button board.kicad_pcb from above]

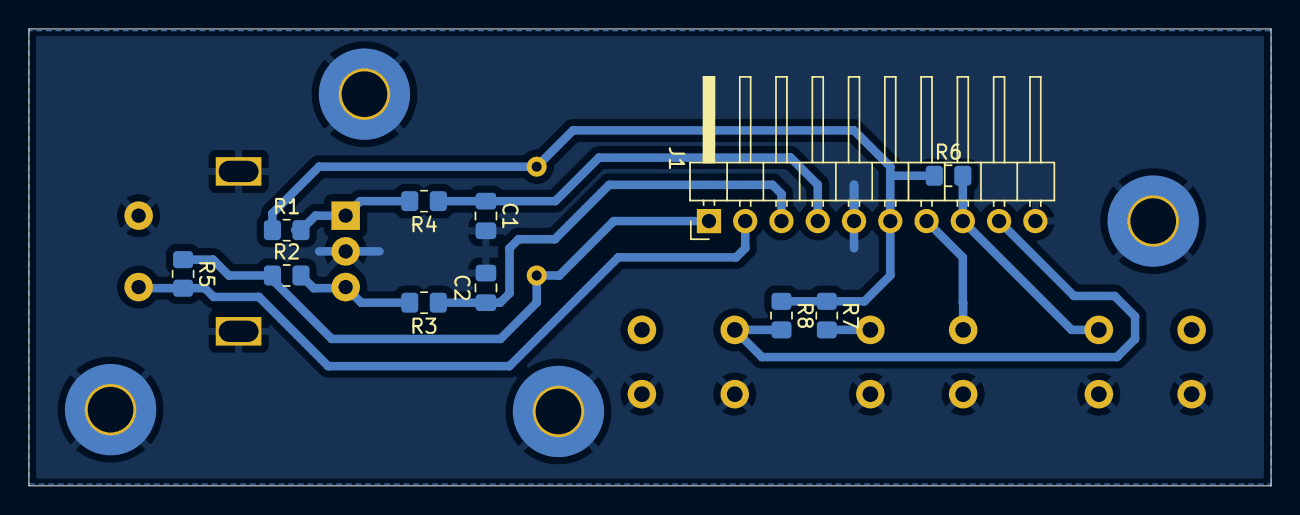
[picture p20: board bt internet radio receiver button board.kicad_pcb from below]

Board: 2 copper layers, 87.0 x 32.0 mm, 20 parts (11 on the bottom side), 11 nets.
