andriish-hw/esp32-audio-streamer/hardware/bt internet radio receiver psu/bt internet radio receiver psu.kicad_pcb

## KiCad design hardware/bt internet radio receiver psu/bt internet radio receiver psu.kicad_pcb (2026-08-18)

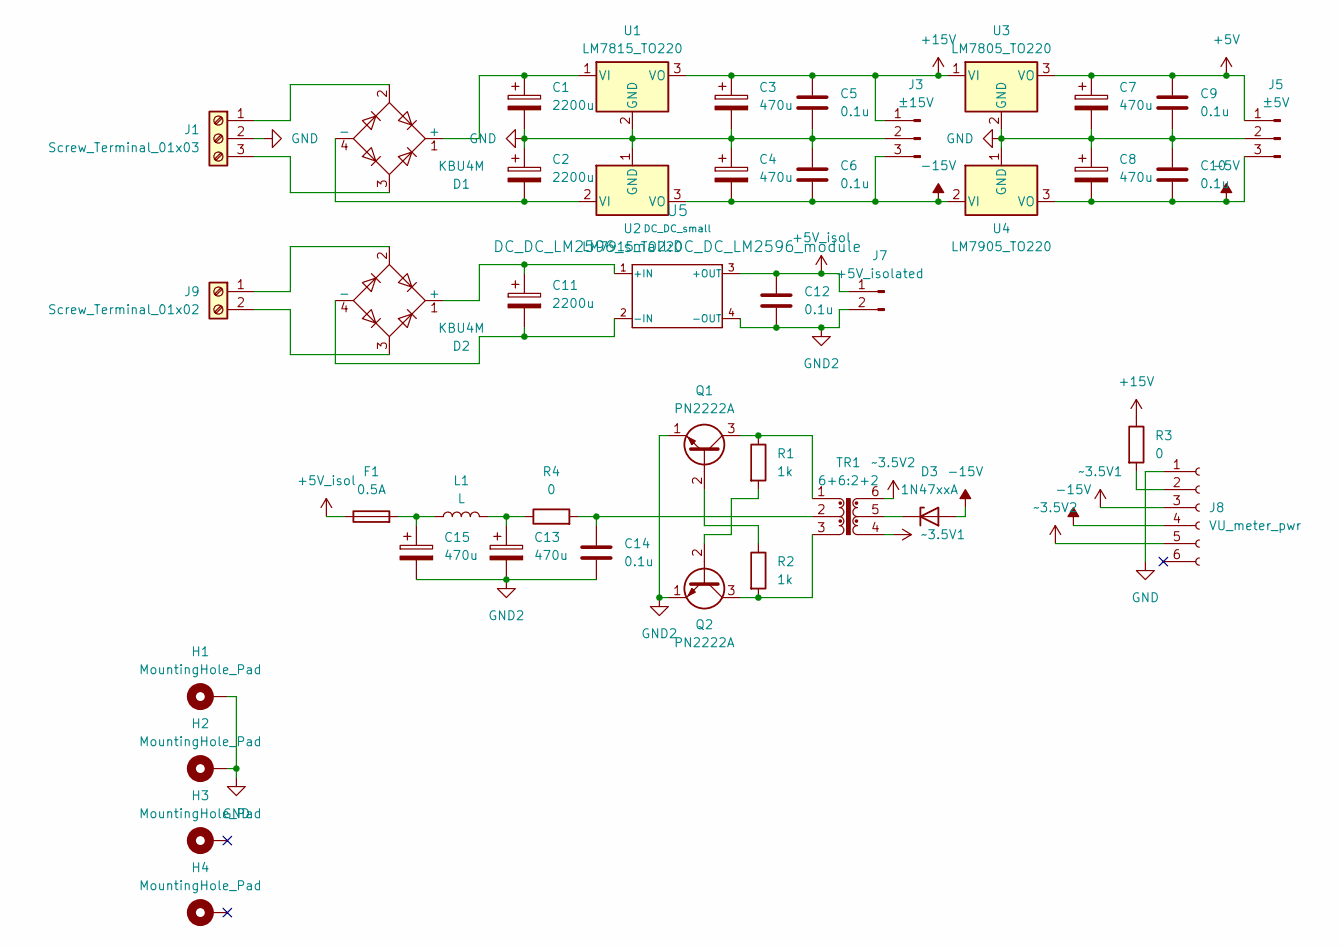
[picture p21: schematic bt internet radio receiver psu.kicad_sch]

Parts:
C1, C2, C11: 2200u; C_Radial_D16.0mm_H25.0mm_P7.50mm
C3, C4, C7, C8, C13, C15: 470u; C_Radial_D10.0mm_H12.5mm_P5.00mm
C5, C6, C9, C10, C12, C14: 0.1u; C_Disc_D4.7mm_W2.5mm_P5.00mm
D1, D2: KBU4M; Diode_Bridge_Vishay_KBPM
D3: 1N47xxA; D_DO-41_SOD81_P5.08mm_Vertical_KathodeUp
F1: 0.5A; Fuseholder_Clip-5x20mm_Keystone_3512_Inline_P23.62x7.27mm_D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
H1, H2, H3, H4: MountingHole_Pad; MountingHole_3.2mm_M3_DIN965_Pad_TopOnly
J1: Screw_Terminal_01x03; TerminalBlock_bornier-3_P5.08mm
J3: ±15V; PinHeader_1x03_P2.54mm_Vertical
J5: ±5V; PinHeader_1x03_P2.54mm_Vertical
J7: +5V_isolated; PinHeader_1x02_P2.54mm_Vertical
J8: VU_meter_pwr; PinSocket_1x06_P2.54mm_Vertical
J9: Screw_Terminal_01x02; TerminalBlock_bornier-2_P5.08mm
L1: L; L_Radial_D12.0mm_P6.00mm_Murata_1900R
Q1, Q2: PN2222A; TO-92_Inline_Wide
R1, R2: 1k; R_Axial_DIN0207_L6.3mm_D2.5mm_P10.16mm_Horizontal
R3: 0; R_Axial_DIN0207_L6.3mm_D2.5mm_P10.16mm_Horizontal
R4: 0; R_Axial_DIN0204_L3.6mm_D1.6mm_P7.62mm_Horizontal
TR1: 6+6:2+2; Transformer_Toroid_Tapped_D=23mm_d=13mm
U1: LM7815_TO220; TO-220-3_Vertical
U2: LM7915_TO220; TO-220-3_Vertical
U3: LM7805_TO220; TO-220-3_Vertical
U4: LM7905_TO220; TO-220-3_Vertical
U5: DC_DC_small; DC_DC_LM2596_module

Connections:
+5V: C7.1, C9.1, J5.1, U3.3 (VO)
+5V_isol: C12.1, F1.1, J7.1, U5.3 (+OUT)
+15V: C3.1, C5.1, J3.1, R3.1, U1.3 (VO), U3.1 (VI)
-5V: C8.2, C10.2, J5.3, U4.3 (VO)
-15V: C4.2, C6.2, D3.2 (A), J3.3, J8.4, U2.3 (VO), U4.2 (VI)
GND: C1.2, C2.1, C3.2, C4.1, C5.2, C6.1, C7.2, C8.1, C9.2, C10.1, H1.1, H2.1, J1.2, J3.2, J5.2, J8.1, U1.2 (GND), U2.1 (GND), U3.2 (GND), U4.1 (GND)
GND2: C12.2, C13.2, C14.2, C15.2, J7.2, Q1.1 (E), Q2.1 (E), U5.4 (-OUT)
unnamed: C13.1, L1.2, R4.1
unnamed: C14.1, R4.2, TR1.2
unnamed: C15.1, F1.2, L1.1
unnamed: C1.1, D1.1 (+), U1.1 (VI)
unnamed: C2.2, D1.4 (-), U2.2 (VI)
unnamed: C11.1, D2.1 (+), U5.1 (+IN)
unnamed: C11.2, D2.4 (-), U5.2 (-IN)
unnamed: D3.1 (K), TR1.5
unnamed: D1.2, J1.1
unnamed: D1.3, J1.3
unnamed: J8.2, R3.2
unnamed: D2.2, J9.1
unnamed: D2.3, J9.2
unnamed: Q1.2 (B), R2.1
unnamed: Q1.3 (C), R1.1, TR1.1
unnamed: Q2.2 (B), R1.2
unnamed: Q2.3 (C), R2.2, TR1.3
~3.5V1: J8.3, TR1.4
~3.5V2: J8.5, TR1.6

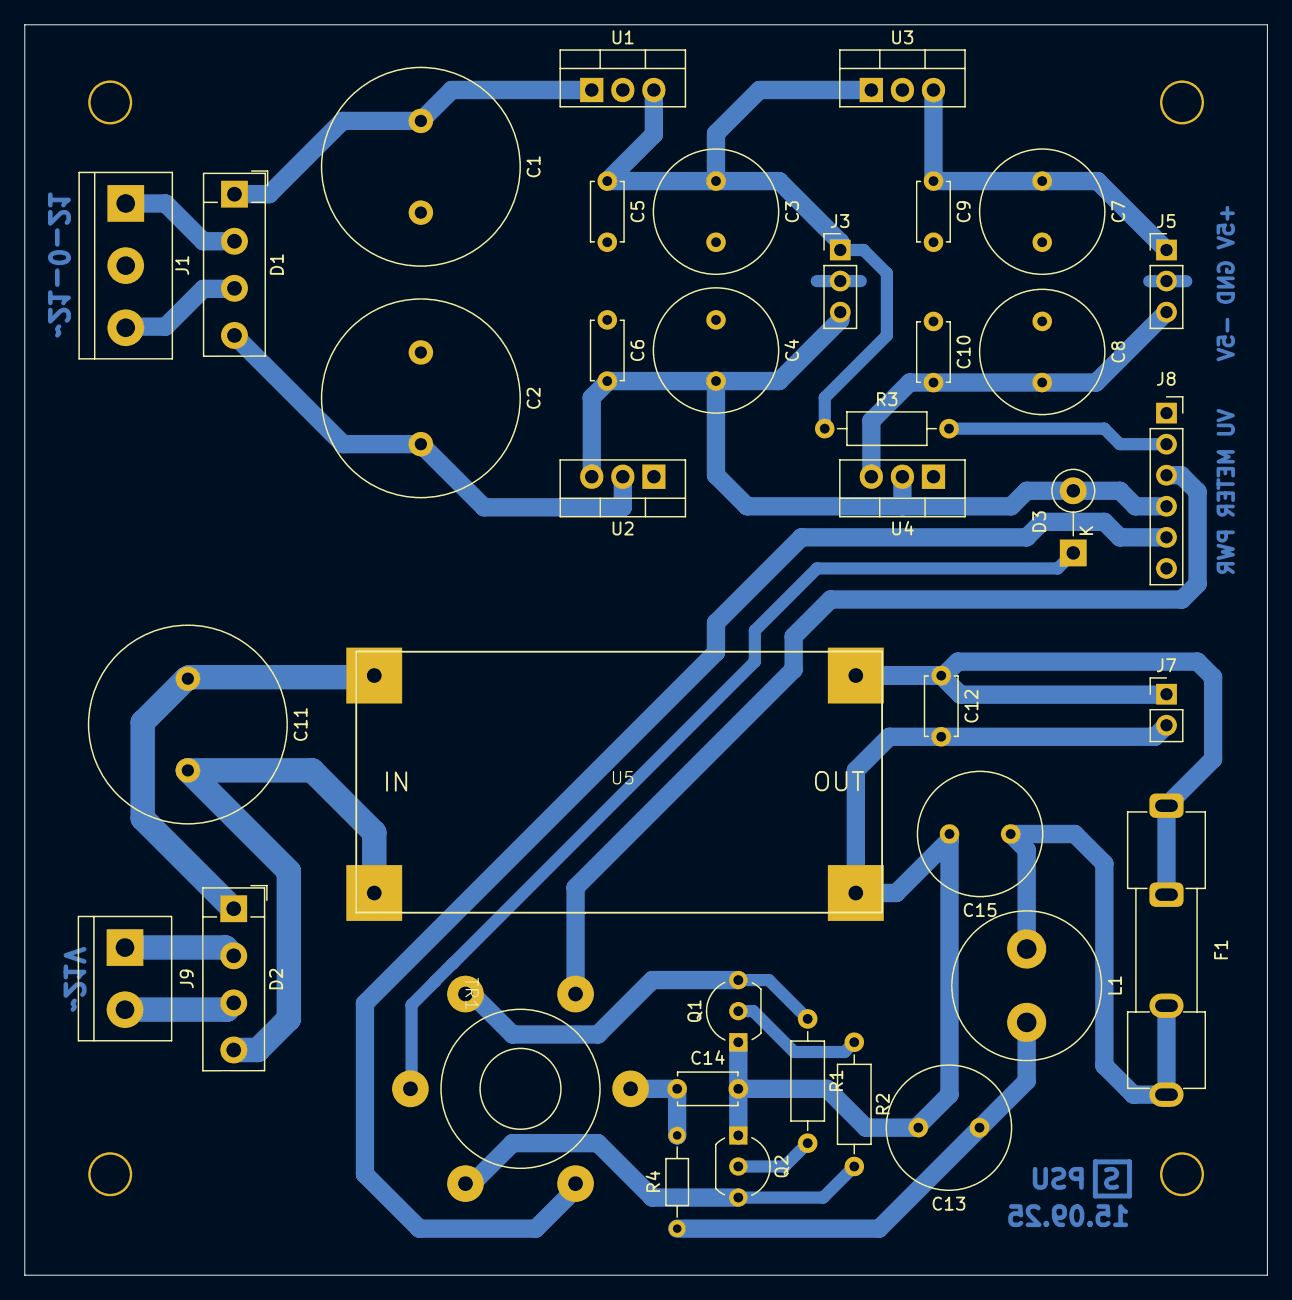
[picture p22: board bt internet radio receiver psu.kicad_pcb from above]

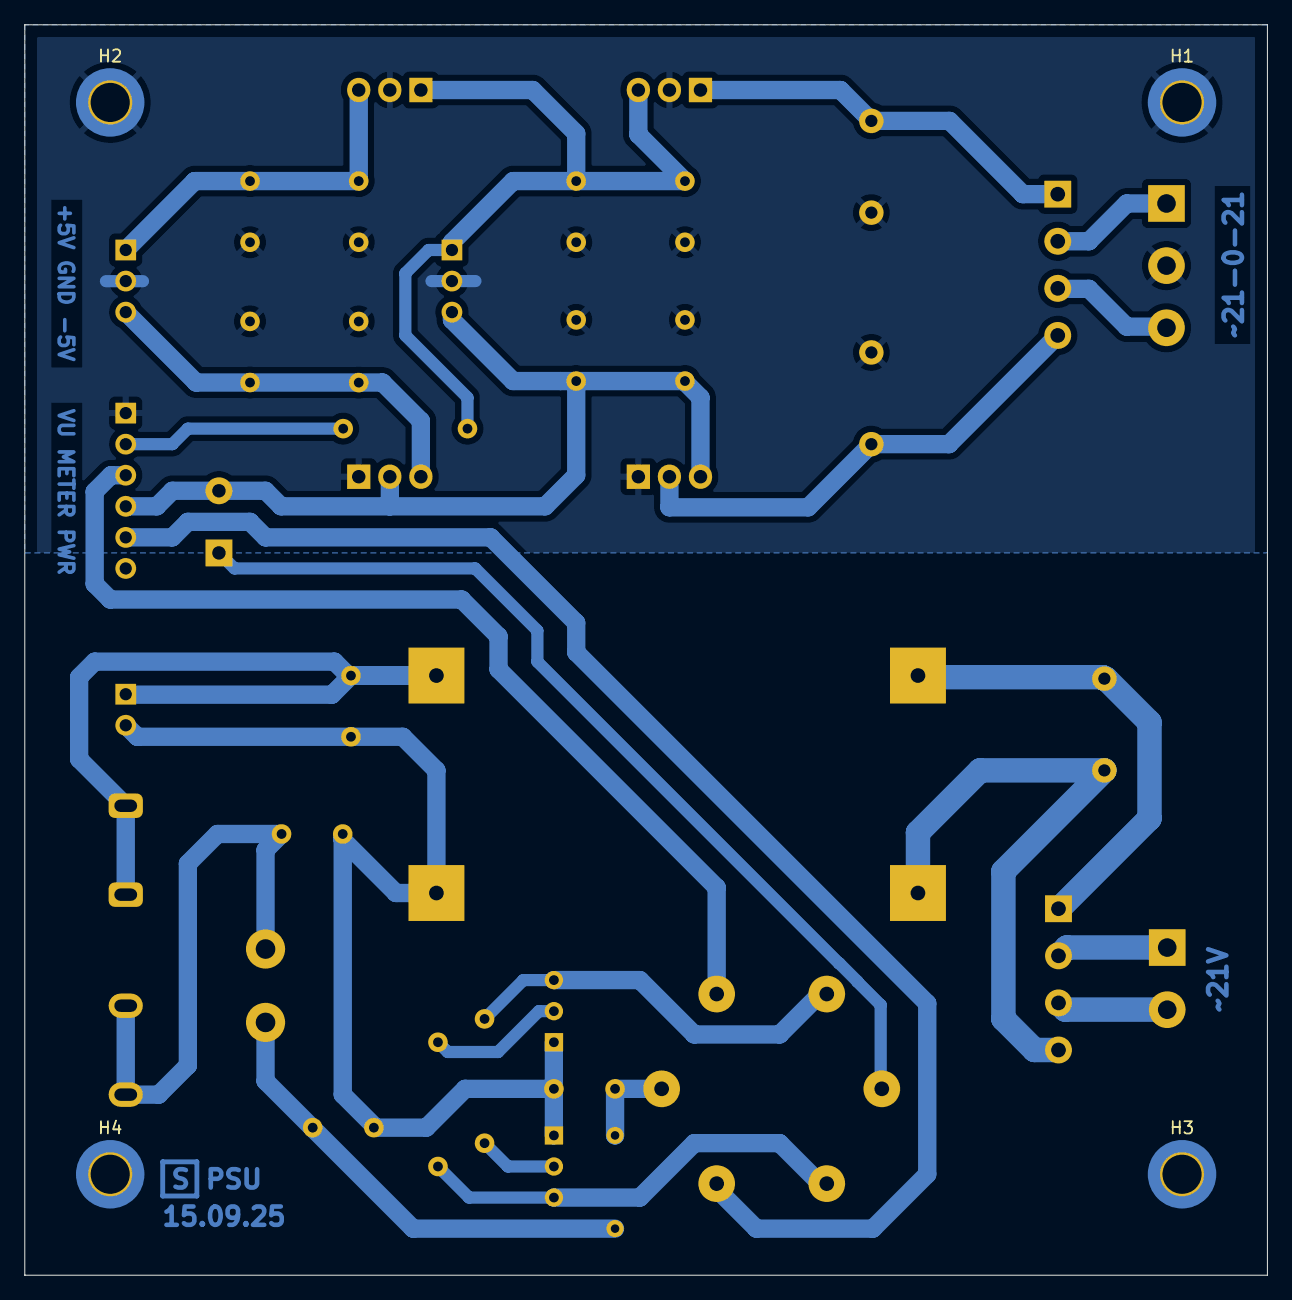
[picture p23: board bt internet radio receiver psu.kicad_pcb from below]

Board: 2 copper layers, 101.6 x 102.2 mm, 42 parts (4 on the bottom side), 26 nets.
