andriish-hw/esp32-audio-streamer/hardware/bt internet radio receiver mainboard/bt internet radio receiver mainboard.kicad_pcb

## KiCad design hardware/bt internet radio receiver mainboard/bt internet radio receiver mainboard.kicad_pcb (2026-08-18)

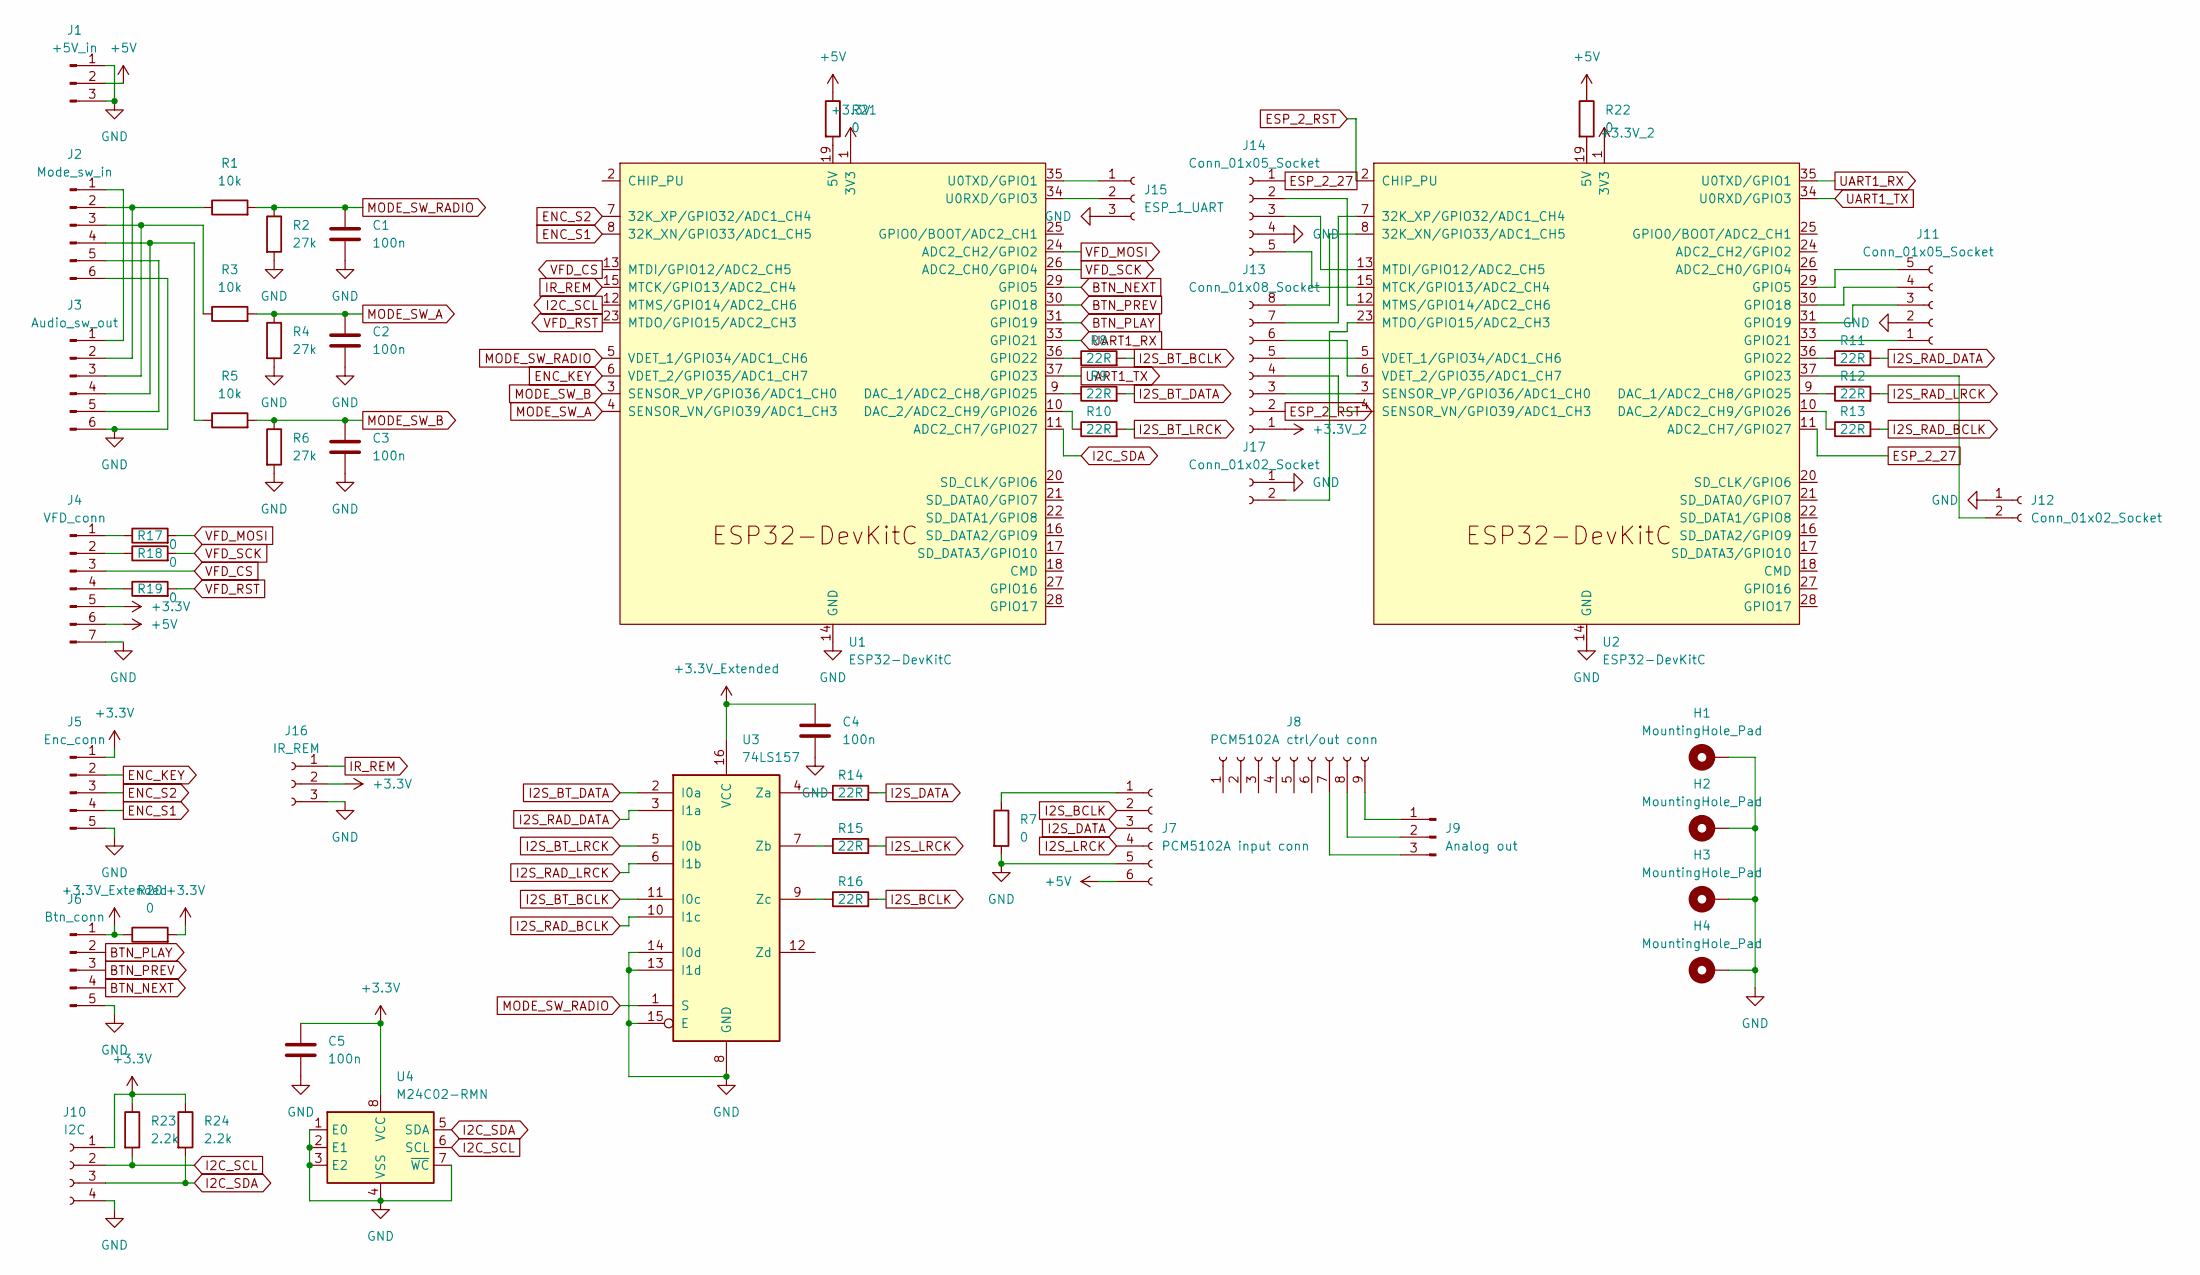
[picture p24: schematic bt internet radio receiver mainboard.kicad_sch]

Parts:
C1, C2, C3: 100n; C_Disc_D7.5mm_W5.0mm_P10.00mm
C4, C5: 100n; C_1206_3216Metric_Pad1.33x1.80mm_HandSolder
H1, H2, H3, H4: MountingHole_Pad; MountingHole_3.2mm_M3_DIN965_Pad_TopOnly
J1: +5V_in; PinHeader_1x03_P2.54mm_Vertical
J2: Mode_sw_in; PinHeader_1x06_P2.54mm_Vertical
J3: Audio_sw_out; PinHeader_1x06_P2.54mm_Vertical
J4: VFD_conn; PinHeader_1x07_P2.54mm_Vertical
J5: Enc_conn; PinHeader_1x05_P2.54mm_Vertical
J6: Btn_conn; PinHeader_1x05_P2.54mm_Vertical
J7: PCM5102A input conn; PinSocket_1x06_P2.54mm_Vertical
J8: PCM5102A ctrl/out conn; PinSocket_1x09_P2.54mm_Vertical
J9: Analog out; PinHeader_1x03_P2.54mm_Vertical
J10: I2C; PinSocket_1x04_P2.54mm_Vertical
J11, J14: Conn_01x05_Socket; PinSocket_1x05_P2.54mm_Vertical
J12, J17: Conn_01x02_Socket; PinSocket_1x02_P2.54mm_Vertical
J13: Conn_01x08_Socket; PinSocket_1x08_P2.54mm_Vertical
J15: ESP_1_UART; PinSocket_1x03_P2.54mm_Vertical
J16: IR_REM; PinSocket_1x03_P2.54mm_Vertical
R1, R3, R5: 10k; R_Axial_DIN0207_L6.3mm_D2.5mm_P10.16mm_Horizontal
R2, R4, R6: 27k; R_Axial_DIN0207_L6.3mm_D2.5mm_P10.16mm_Horizontal
R7, R18, R20: 0; R_Axial_DIN0207_L6.3mm_D2.5mm_P10.16mm_Horizontal
R8, R9, R10, R11, R12, R13, R14, R15, R16: 22R; R_Axial_DIN0207_L6.3mm_D2.5mm_P10.16mm_Horizontal
R17, R19: 0; R_Axial_DIN0207_L6.3mm_D2.5mm_P15.24mm_Horizontal
R21, R22: 0; R_Axial_DIN0204_L3.6mm_D1.6mm_P7.62mm_Horizontal
R23: 2.2k; R_Axial_DIN0204_L3.6mm_D1.6mm_P2.54mm_Vertical
R24: 2.2k; R_Axial_DIN0204_L3.6mm_D1.6mm_P5.08mm_Vertical
U1, U2: ESP32-DevKitC
U3: 74LS157; SOIC-16_3.9x9.9mm_P1.27mm
U4: M24C02-RMN; SOIC-8_3.9x4.9mm_P1.27mm

Connections:
+3.3V: C5.1, J4.5, J5.1, J10.1, J16.2, R20.2, R23.1, R24.1, U1.1 (3V3), U4.8 (VCC)
+3.3V_2: J13.1, U2.1 (3V3)
+3.3V_Extended: C4.1, J6.1, R20.1, U3.16 (VCC)
+5V: J1.2, J4.6, J7.6, R21.1, R22.1
BTN_NEXT: J6.4, U1.29 (GPIO5)
BTN_PLAY: J6.2, U1.31 (GPIO19)
BTN_PREV: J6.3, U1.30 (GPIO18)
ENC_KEY: J5.2, U1.6 (VDET_2/GPIO35/ADC1_CH7)
ENC_S1: J5.4, U1.8 (32K_XN/GPIO33/ADC1_CH5)
ENC_S2: J5.3, U1.7 (32K_XP/GPIO32/ADC1_CH4)
ESP_2_27: J14.1, U2.11 (ADC2_CH7/GPIO27)
ESP_2_RST: J13.2, U2.2 (CHIP_PU)
GND: C1.2, C2.2, C3.2, C4.2, C5.2, H1.1, H2.1, H3.1, H4.1, J1.1, J1.3, J2.6, J3.6, J4.7, J5.5, J6.5, J7.5, J10.4, J11.2, J12.1, J14.4, J15.3, J16.3, J17.1, R2.2, R4.2, R6.2, R7.2, U1.14 (GND), U1.32 (GND), U1.38 (GND), U2.14 (GND), U2.32 (GND), U2.38 (GND), U3.8 (GND), U3.13 (I1d), U3.14 (I0d), U3.15 (E), U4.1 (E0), U4.2 (E1), U4.3 (E2), U4.4 (VSS), U4.7 (~WC)
I2C_SCL: J10.2, R23.2, U1.12 (MTMS/GPIO14/ADC2_CH6), U4.6 (SCL)
I2C_SDA: J10.3, R24.2, U1.11 (ADC2_CH7/GPIO27), U4.5 (SDA)
I2S_BCLK: J7.2, R16.2
I2S_BT_BCLK: R8.2, U3.11 (I0c)
I2S_BT_DATA: R9.2, U3.2 (I0a)
I2S_BT_LRCK: R10.2, U3.5 (I0b)
I2S_DATA: J7.3, R14.2
I2S_LRCK: J7.4, R15.2
I2S_RAD_BCLK: R13.2, U3.10 (I1c)
I2S_RAD_DATA: R11.2, U3.3 (I1a)
I2S_RAD_LRCK: R12.2, U3.6 (I1b)
IR_REM: J16.1, U1.15 (MTCK/GPIO13/ADC2_CH4)
MODE_SW_A: C2.1, R3.2, R4.1, U1.4 (SENSOR_VN/GPIO39/ADC1_CH3)
MODE_SW_B: C3.1, R5.2, R6.1, U1.3 (SENSOR_VP/GPIO36/ADC1_CH0)
MODE_SW_RADIO: C1.1, R1.2, R2.1, U1.5 (VDET_1/GPIO34/ADC1_CH6), U3.1 (S)
unnamed: J2.1, J3.1
unnamed: J2.2, J3.2, R1.1
unnamed: J2.3, J3.3, R3.1
unnamed: J2.4, J3.4, R5.1
unnamed: J2.5, J3.5
unnamed: J4.1, R17.1
unnamed: J4.2, R18.1
unnamed: J4.4, R19.1
unnamed: J7.1, R7.1
unnamed: J8.7, J9.3
unnamed: J8.8, J9.2
unnamed: J8.9, J9.1
unnamed: J11.1, U2.33 (GPIO21)
unnamed: J11.3, U2.31 (GPIO19)
unnamed: J11.4, U2.30 (GPIO18)
unnamed: J11.5, U2.29 (GPIO5)
unnamed: J12.2, U2.37 (GPIO23)
unnamed: J13.3, U2.3 (SENSOR_VP/GPIO36/ADC1_CH0)
unnamed: J13.4, U2.4 (SENSOR_VN/GPIO39/ADC1_CH3)
unnamed: J13.5, U2.5 (VDET_1/GPIO34/ADC1_CH6)
unnamed: J13.6, U2.6 (VDET_2/GPIO35/ADC1_CH7)
unnamed: J13.7, U2.7 (32K_XP/GPIO32/ADC1_CH4)
unnamed: J13.8, U2.8 (32K_XN/GPIO33/ADC1_CH5)
unnamed: J14.2, U2.12 (MTMS/GPIO14/ADC2_CH6)
unnamed: J14.3, U2.13 (MTDI/GPIO12/ADC2_CH5)
unnamed: J14.5, U2.15 (MTCK/GPIO13/ADC2_CH4)
unnamed: J15.1, U1.35 (U0TXD/GPIO1)
unnamed: J15.2, U1.34 (U0RXD/GPIO3)
unnamed: J17.2, U2.23 (MTDO/GPIO15/ADC2_CH3)
unnamed: R21.2, U1.19 (5V)
unnamed: R9.1, U1.9 (DAC_1/ADC2_CH8/GPIO25)
unnamed: R10.1, U1.10 (DAC_2/ADC2_CH9/GPIO26)
unnamed: R8.1, U1.36 (GPIO22)
unnamed: R22.2, U2.19 (5V)
unnamed: R12.1, U2.9 (DAC_1/ADC2_CH8/GPIO25)
unnamed: R13.1, U2.10 (DAC_2/ADC2_CH9/GPIO26)
unnamed: R11.1, U2.36 (GPIO22)
unnamed: R14.1, U3.4 (Za)
unnamed: R15.1, U3.7 (Zb)
unnamed: R16.1, U3.9 (Zc)
UART1_RX: U1.33 (GPIO21), U2.35 (U0TXD/GPIO1)
UART1_TX: U1.37 (GPIO23), U2.34 (U0RXD/GPIO3)
VFD_CS: J4.3, U1.13 (MTDI/GPIO12/ADC2_CH5)
VFD_MOSI: R17.2, U1.24 (ADC2_CH2/GPIO2)
VFD_RST: R19.2, U1.23 (MTDO/GPIO15/ADC2_CH3)
VFD_SCK: R18.2, U1.26 (ADC2_CH0/GPIO4)
