andriish-hw/esp32-audio-streamer/hardware/bt internet radio receiver mainboard/bt internet radio receiver mainboard.kicad_pcb

## KiCad design hardware/bt internet radio receiver mainboard/bt internet radio receiver mainboard.kicad_pcb (continued)

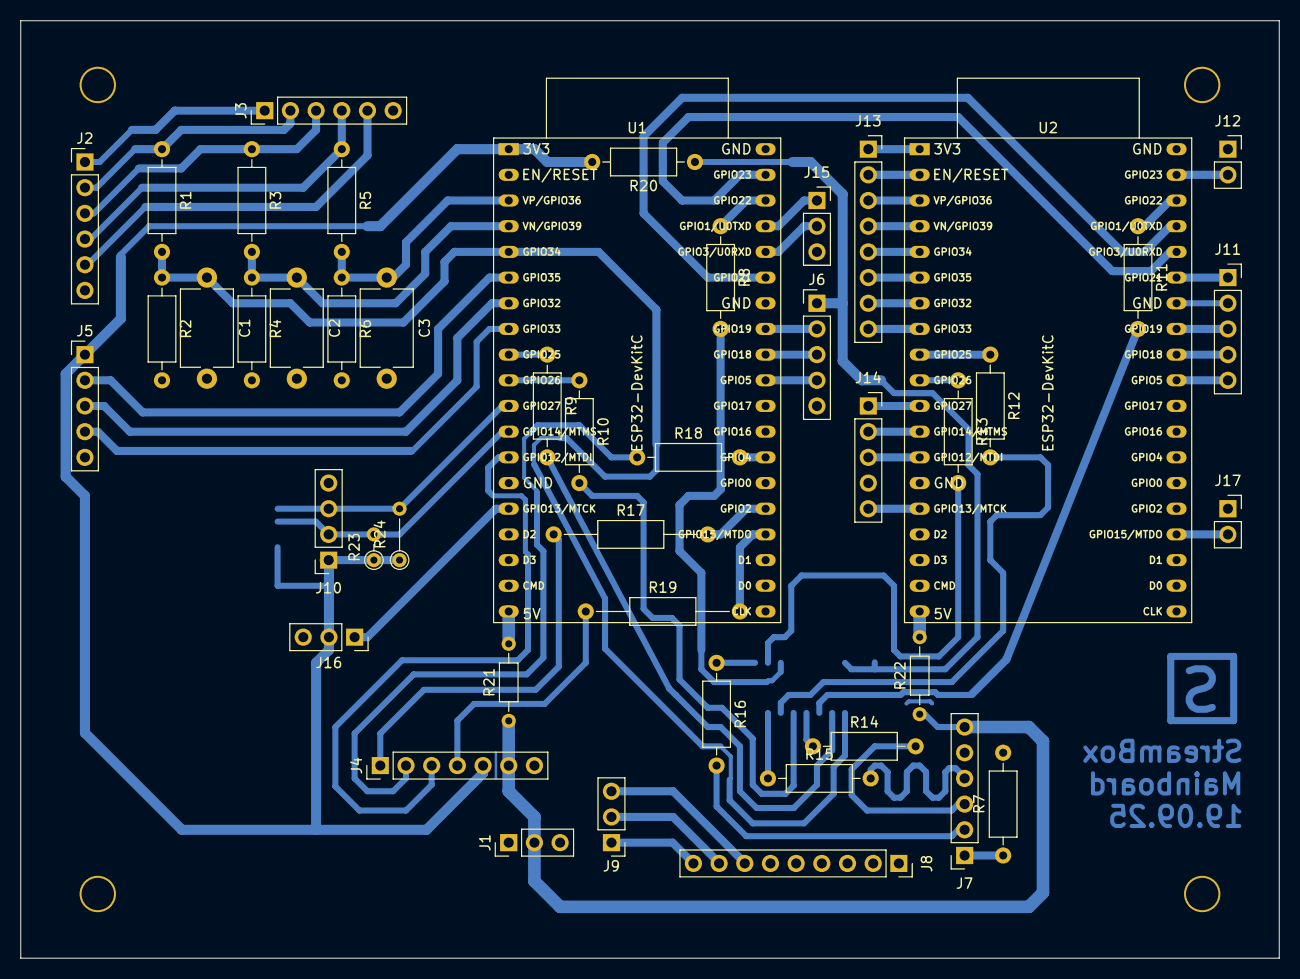
[picture p25: board bt internet radio receiver mainboard.kicad_pcb from above]

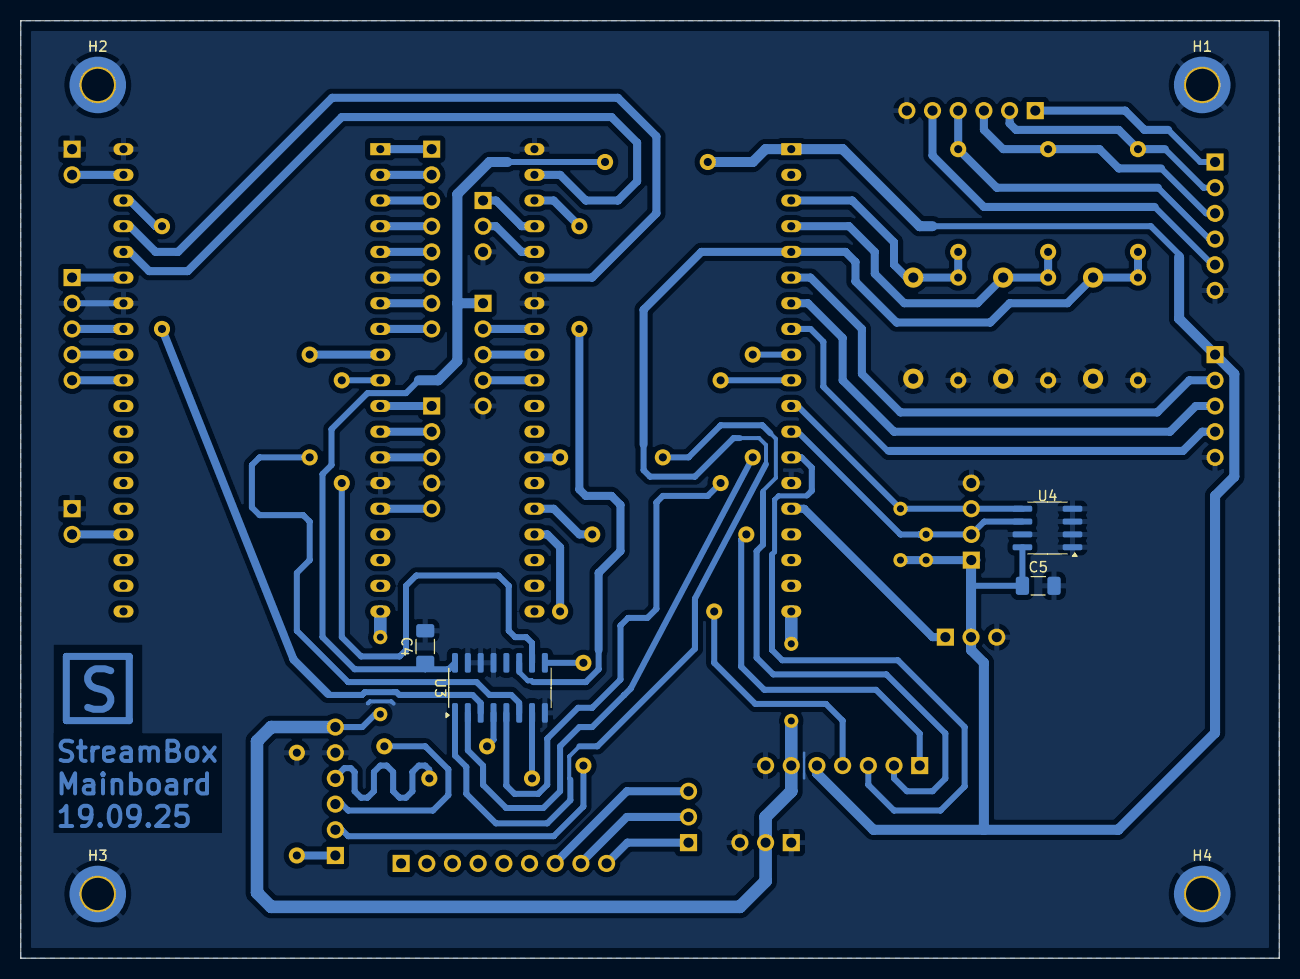
[picture p26: board bt internet radio receiver mainboard.kicad_pcb from below]

Board: 2 copper layers, 124.5 x 92.7 mm, 54 parts (8 on the bottom side), 74 nets.
