andriish-hw/esp32-audio-streamer/hardware/opamp headphones amp with discrete transistors/opamp headphones amp with discrete transistors.kicad_pcb

## KiCad design hardware/opamp headphones amp with discrete transistors/opamp headphones amp with discrete transistors.kicad_pcb (2026-08-18)

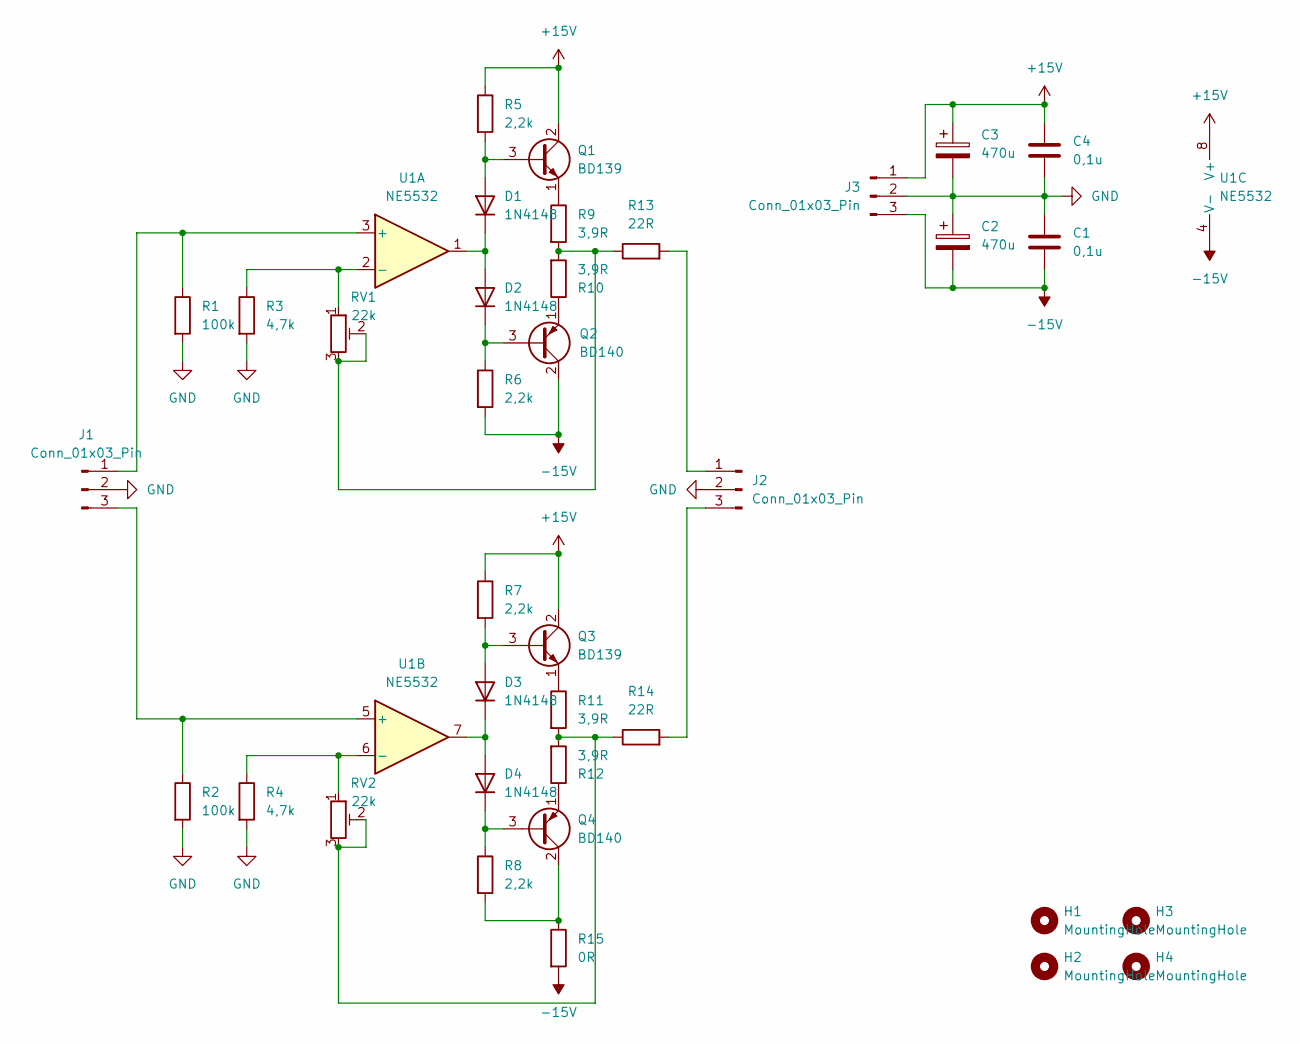
[picture p27: schematic opamp headphones amp with discrete transistors.kicad_sch]

Parts:
C1, C4: 0,1u; C_Disc_D5.0mm_W2.5mm_P5.00mm
C2, C3: 470u; CP_Radial_D8.0mm_P2.50mm
D1, D2, D3, D4: 1N4148; D_DO-35_SOD27_P7.62mm_Horizontal
H1, H2, H3, H4: MountingHole; MountingHole_3.2mm_M3_DIN965_Pad
J1, J2, J3: Conn_01x03_Pin; PinHeader_1x03_P2.54mm_Vertical
Q1, Q3: BD139; TO-126-3_Vertical
Q2, Q4: BD140; TO-126-3_Vertical
R1, R2: 100k; R_Axial_DIN0207_L6.3mm_D2.5mm_P10.16mm_Horizontal
R3, R4: 4,7k; R_Axial_DIN0207_L6.3mm_D2.5mm_P10.16mm_Horizontal
R5, R6, R7, R8: 2,2k; R_Axial_DIN0207_L6.3mm_D2.5mm_P10.16mm_Horizontal
R9, R10, R11, R12: 3,9R; R_Axial_DIN0309_L9.0mm_D3.2mm_P5.08mm_Vertical
R13, R14: 22R; R_Axial_DIN0309_L9.0mm_D3.2mm_P5.08mm_Vertical
R15: 0R; R_Axial_DIN0204_L3.6mm_D1.6mm_P7.62mm_Horizontal
RV1, RV2: 22k; Potentiometer_Runtron_RM-065_Vertical
U1: NE5532; DIP-8_W7.62mm_Socket_LongPads

Connections:
+15V: C3.1, C4.1, J3.1, Q1.2 (C), Q3.2 (C), R5.1, R7.1, U1.8 (V+)
-15V: C1.2, C2.2, J3.3, Q2.2 (C), R6.2, R15.2, U1.4 (V-)
GND: C1.1, C2.1, C3.2, C4.2, J1.2, J2.2, J3.2, R1.2, R2.2, R3.2, R4.2
unnamed: D1.2 (A), Q1.3 (B), R5.2
unnamed: D1.1 (K), D2.2 (A), U1.1
unnamed: D2.1 (K), Q2.3 (B), R6.1
unnamed: D3.2 (A), Q3.3 (B), R7.2
unnamed: D3.1 (K), D4.2 (A), U1.7
unnamed: D4.1 (K), Q4.3 (B), R8.1
unnamed: J1.1, R1.1, U1.3 (+)
unnamed: J1.3, R2.1, U1.5 (+)
unnamed: J2.1, R13.2
unnamed: J2.3, R14.2
unnamed: Q1.1 (E), R9.1
unnamed: Q2.1 (E), R10.1
unnamed: Q3.1 (E), R11.1
unnamed: Q4.2 (C), R8.2, R15.1
unnamed: Q4.1 (E), R12.1
unnamed: R9.2, R10.2, R13.1, RV1.2, RV1.3
unnamed: R11.2, R12.2, R14.1, RV2.2, RV2.3
unnamed: R3.1, RV1.1, U1.2 (-)
unnamed: R4.1, RV2.1, U1.6 (-)

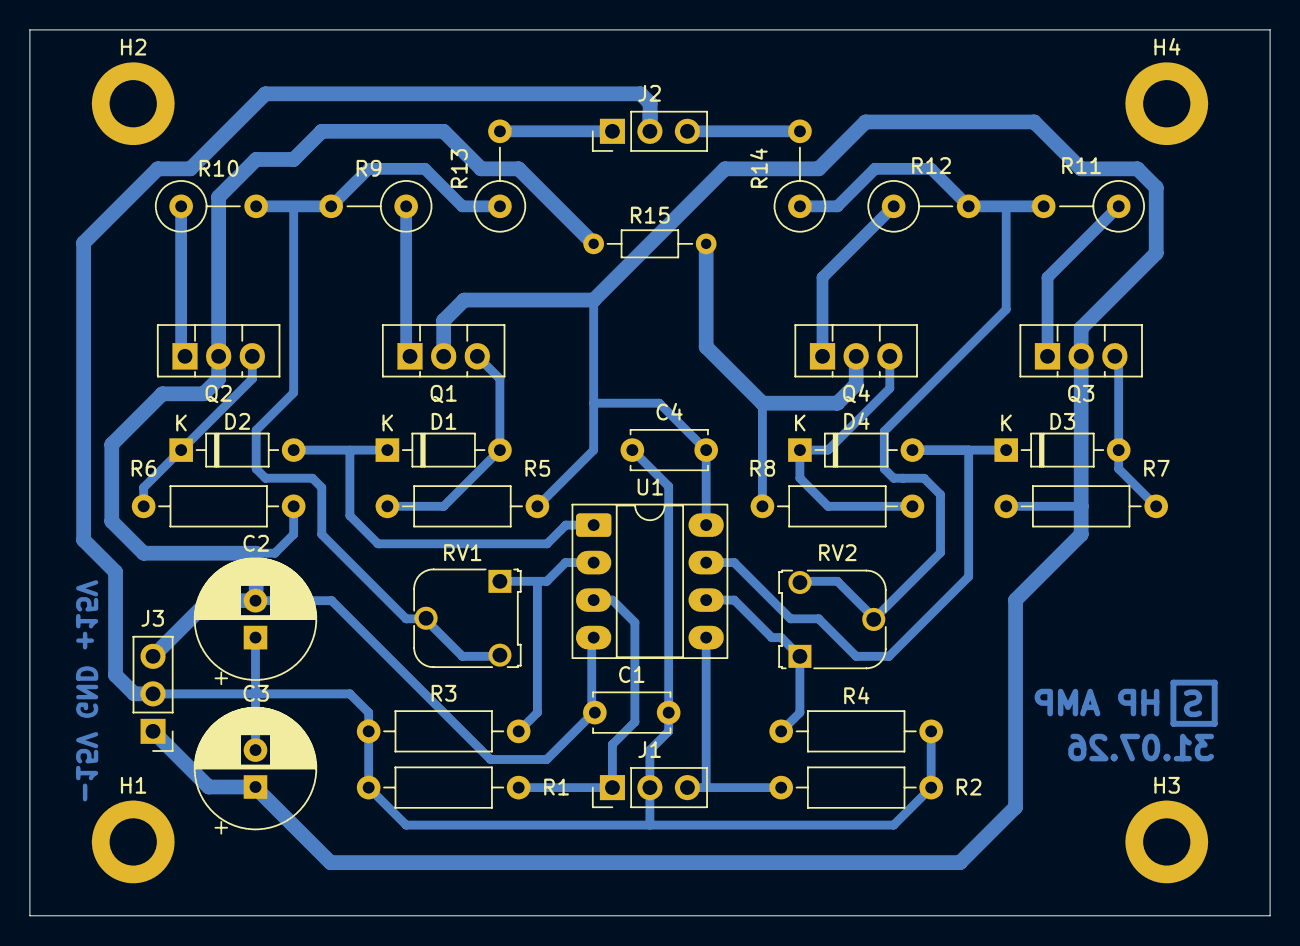
[picture p28: board opamp headphones amp with discrete transistors.kicad_pcb from above]

Board: 2 copper layers, 84.0 x 60.0 mm, 37 parts (0 on the bottom side), 22 nets.
