andriish-hw/esp32-audio-streamer/hardware/VU meter PP4/VU meter PP4.kicad_pcb

## KiCad design hardware/VU meter PP4/VU meter PP4.kicad_pcb (2026-08-18)

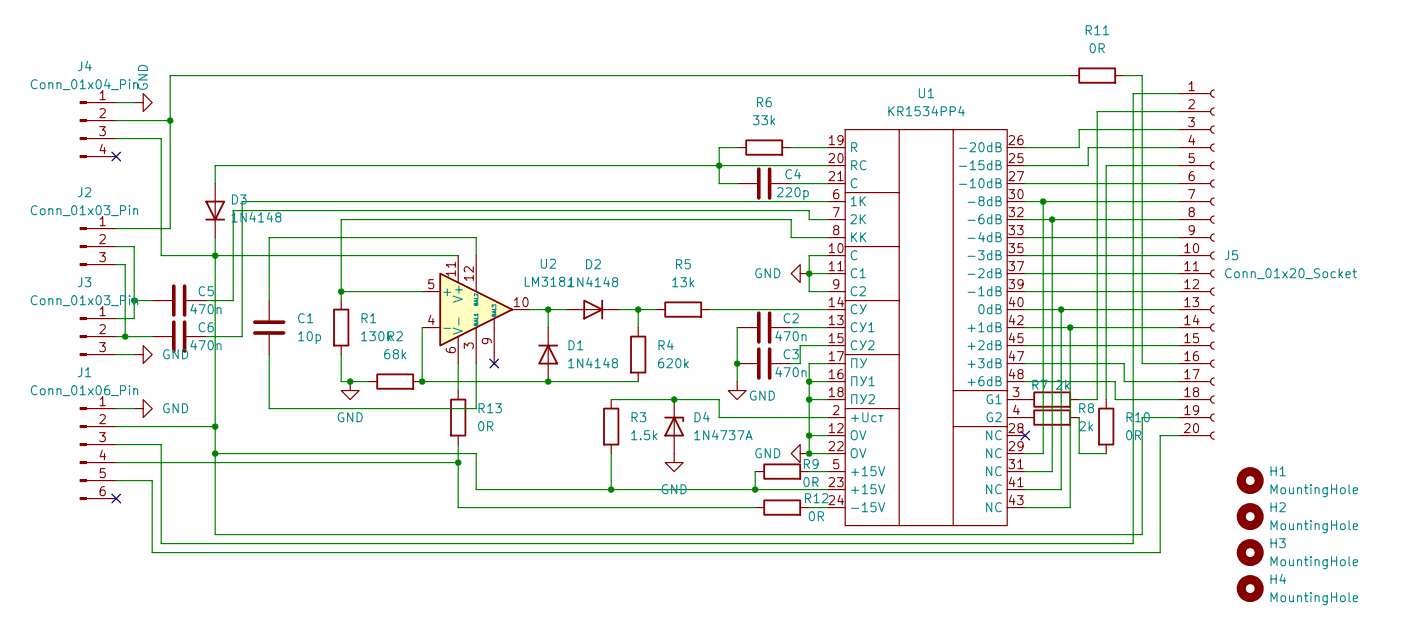
[picture p29: schematic VU meter PP4.kicad_sch]

Parts:
C1: 10p; C_Disc_D7.5mm_W5.0mm_P7.50mm
C2, C3, C5, C6: 470n; C_Rect_L13.0mm_W8.0mm_P10.00mm_FKS3_FKP3_MKS4
C4: 220p; C_Disc_D7.5mm_W5.0mm_P10.00mm
D1, D2: 1N4148; D_DO-35_SOD27_P7.62mm_Horizontal
D3: 1N4148; D_DO-35_SOD27_P10.16mm_Horizontal
D4: 1N4737A; D_DO-41_SOD81_P12.70mm_Horizontal
H1, H2, H3, H4: MountingHole; MountingHole_3.2mm_M3_DIN965_Pad
J1: Conn_01x06_Pin; PinHeader_1x06_P2.54mm_Vertical
J2: Conn_01x03_Pin; PinHeader_1x03_P2.54mm_Horizontal
J3: Conn_01x03_Pin; PinHeader_1x03_P2.54mm_Vertical
J4: Conn_01x04_Pin; PinHeader_1x04_P2.54mm_Vertical
J5: Conn_01x20_Socket; PinSocket_1x20_P2.54mm_Vertical
R1: 130k; R_Axial_DIN0309_L9.0mm_D3.2mm_P12.70mm_Horizontal
R2: 68k; R_Axial_DIN0309_L9.0mm_D3.2mm_P12.70mm_Horizontal
R3: 1.5k; R_Axial_DIN0309_L9.0mm_D3.2mm_P12.70mm_Horizontal
R4: 620k; R_Axial_DIN0309_L9.0mm_D3.2mm_P12.70mm_Horizontal
R5: 13k; R_Axial_DIN0309_L9.0mm_D3.2mm_P12.70mm_Horizontal
R6: 33k; R_Axial_DIN0309_L9.0mm_D3.2mm_P12.70mm_Horizontal
R7, R8: 2k; R_Axial_DIN0309_L9.0mm_D3.2mm_P12.70mm_Horizontal
R9: 0R; R_Axial_DIN0309_L9.0mm_D3.2mm_P12.70mm_Horizontal
R10, R11, R12: 0R; R_Axial_DIN0204_L3.6mm_D1.6mm_P7.62mm_Horizontal
R13: 0R; R_Axial_DIN0204_L3.6mm_D1.6mm_P5.08mm_Horizontal
U1: KR1534PP4; DIP-48_Staggered_KR1534PP4
U2: LM318J; DIP-14_W7.62mm

Connections:
GND: C2.1, C3.1, D4.2 (A), J1.1, J3.3, J4.1, R1.2, R2.1, U1.9 (С2), U1.10 (С), U1.11 (С1), U1.12 (OV), U1.16 (ПУ1), U1.17 (ПУ), U1.18 (ПУ2), U1.22 (OV)
unnamed: D1.2 (A), R2.2, R4.2, U2.4 (-)
unnamed: D1.1 (K), D2.2 (A), U2.10
unnamed: D2.1 (K), R4.1, R5.1
unnamed: C4.1, D3.2 (A), R6.1, U1.20 (RC)
unnamed: D3.1 (K), J1.2, J4.3, J5.19, R3.2, R9.1, U1.23 (+15V), U2.11 (V+)
unnamed: D4.1 (K), R3.1, U1.2 (+Uст)
unnamed: J1.3, J5.1
unnamed: J1.4, R12.1, R13.2
unnamed: J1.5, J5.20
unnamed: C5.1, J2.2, J3.1
unnamed: C6.1, J2.3, J3.2
unnamed: J2.1, J4.2, R11.1
unnamed: J5.2, R7.2
unnamed: J5.3, U1.26 (-20dB)
unnamed: J5.4, U1.25 (-15dB)
unnamed: J5.5, R10.1
unnamed: J5.6, U1.27 (-10dB)
unnamed: J5.7, U1.29 (NC), U1.30 (-8dB)
unnamed: J5.8, U1.31 (NC), U1.32 (-6dB)
unnamed: J5.9, U1.33 (-4dB)
unnamed: J5.10, U1.35 (-3dB)
unnamed: J5.11, U1.37 (-2dB)
unnamed: J5.12, U1.39 (-1dB)
unnamed: J5.13, U1.40 (0dB), U1.41 (NC)
unnamed: J5.14, U1.42 (+1dB), U1.43 (NC)
unnamed: J5.15, U1.45 (+2dB)
unnamed: J5.16, R11.2
unnamed: J5.17, U1.47 (+3dB)
unnamed: J5.18, U1.48 (+6dB)
unnamed: R9.2, U1.5 (+15V)
unnamed: R8.2, R10.2
unnamed: C6.2, U1.6 (1К)
unnamed: C5.2, U1.7 (2К)
unnamed: R12.2, U1.24 (-15V)
unnamed: C4.2, U1.21 (C)
unnamed: R7.1, U1.3 (G1)
unnamed: R8.1, U1.4 (G2)
unnamed: R6.2, U1.19 (R)
unnamed: R1.1, U1.8 (КК), U2.5 (+)
unnamed: C2.2, U1.13 (СУ1)
unnamed: C3.2, U1.15 (СУ2)
unnamed: R5.2, U1.14 (СУ)
unnamed: C1.1, U2.3 (BAL1)
unnamed: C1.2, U2.12 (BAL2)
unnamed: R13.1, U2.6 (V-)

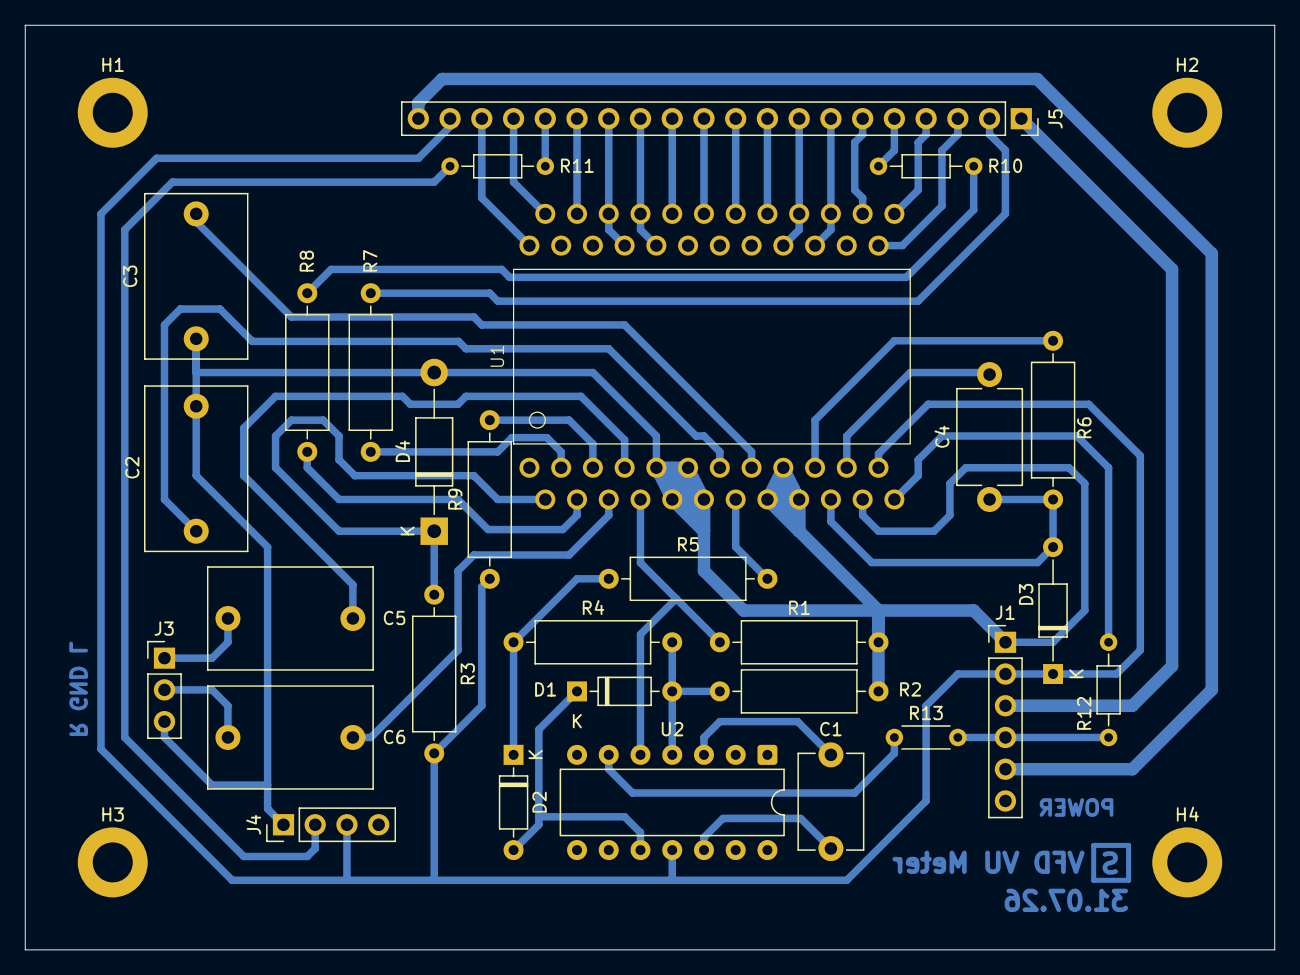
[picture p30: board VU meter PP4.kicad_pcb from above]

Board: 2 copper layers, 100.0 x 74.0 mm, 33 parts (0 on the bottom side), 46 nets.
