andriish-hw/esp32-audio-streamer/hardware/bt internet radio receiver source rotary switch board/bt internet radio receiver source rotary switch board.kicad_pcb

## KiCad design hardware/bt internet radio receiver source rotary switch board/bt internet radio receiver source rotary switch board.kicad_pcb (2026-08-18)

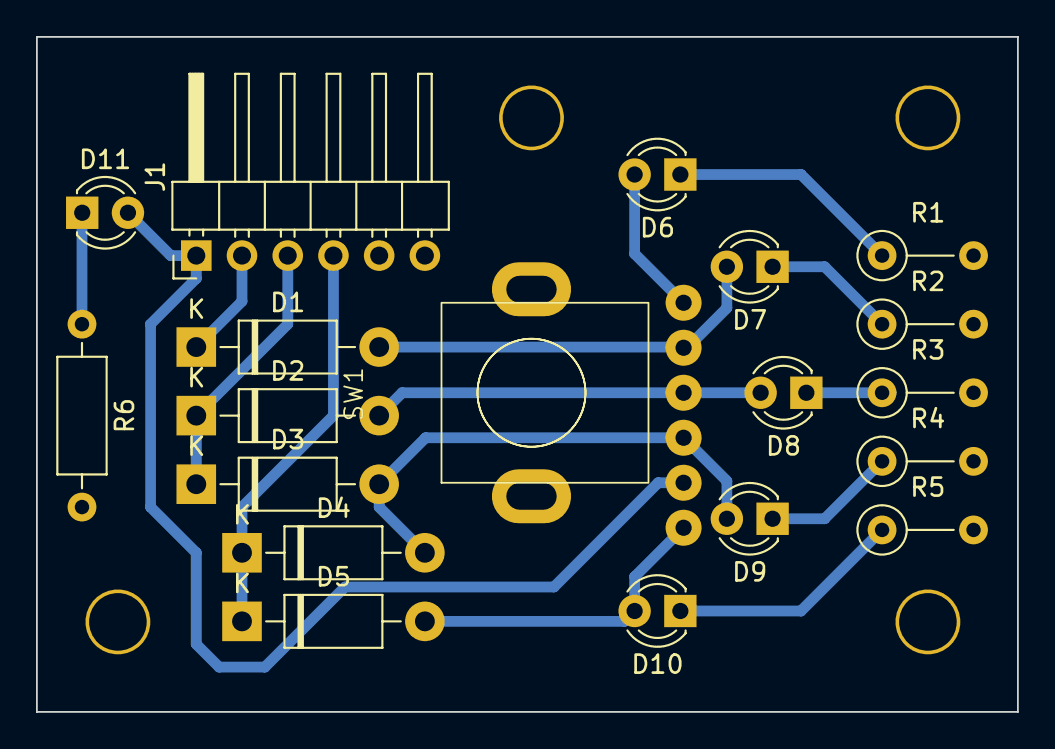
[picture p31: board bt internet radio receiver source rotary switch board.kicad_pcb from above]

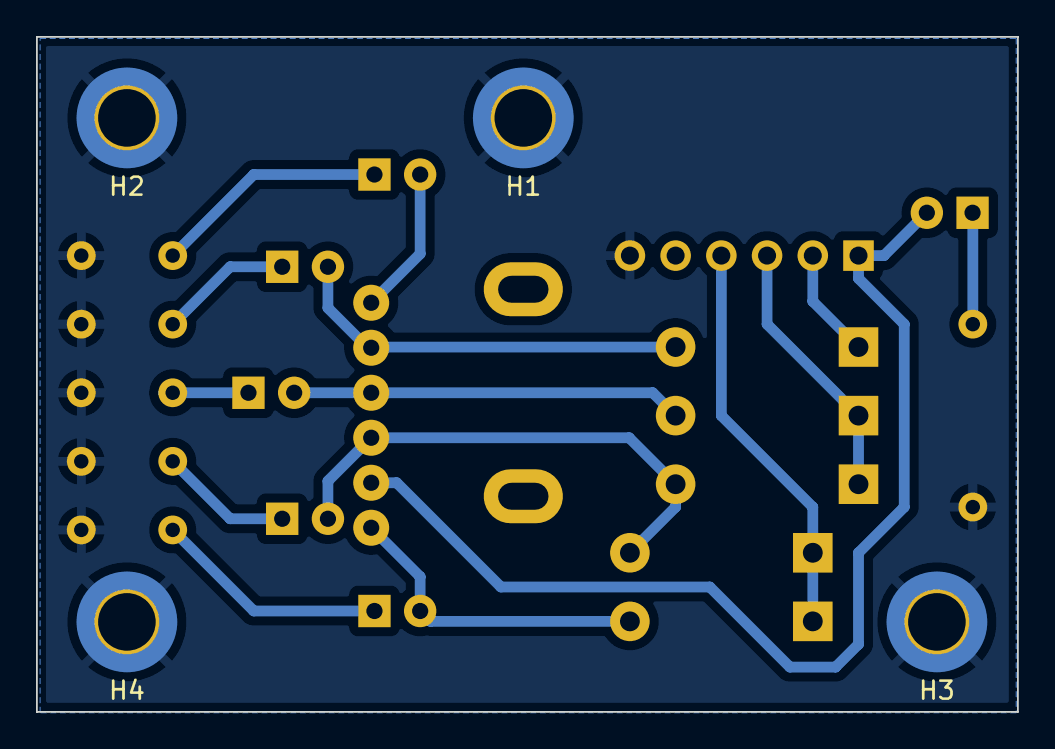
[picture p32: board bt internet radio receiver source rotary switch board.kicad_pcb from below]

Board: 2 copper layers, 54.5 x 37.5 mm, 23 parts (4 on the bottom side), 16 nets.

Parts:
D1, D2, D3, D4, D5: 1N5819; D_DO-41_SOD81_P10.16mm_Horizontal
D6, D7, D8, D9, D10, D11: LED; LED_D3.0mm_FlatTop
H1, H2, H3, H4: MountingHole_Pad; MountingHole_3.2mm_M3_DIN965_Pad_TopOnly
J1: Conn_01x06_Pin; PinHeader_1x06_P2.54mm_Horizontal
R1, R2, R3, R4, R5: 330R; R_Axial_DIN0207_L6.3mm_D2.5mm_P5.08mm_Vertical
R6: 330R; R_Axial_DIN0207_L6.3mm_D2.5mm_P10.16mm_Horizontal
SW1: RS1010_1P5T; RS1010_custom_vertical

Connections:
GND: H1.1, H2.1, H3.1, H4.1, J1.6, R1.2, R2.2, R3.2, R4.2, R5.2, R6.2
unnamed: D1.2 (A), D7.2 (A), SW1.2
unnamed: D1.1 (K), J1.2
unnamed: D2.2 (A), D8.2 (A), SW1.3
unnamed: D2.1 (K), D3.1 (K), J1.3
unnamed: D3.2 (A), D4.2 (A), D9.2 (A), SW1.4
unnamed: D4.1 (K), D5.1 (K), J1.4
unnamed: D6.2 (A), SW1.1
unnamed: D6.1 (K), R1.1
unnamed: D7.1 (K), R2.1
unnamed: D8.1 (K), R3.1
unnamed: D9.1 (K), R4.1
unnamed: D5.2 (A), D10.2 (A), SW1.10
unnamed: D10.1 (K), R5.1
unnamed: D11.2 (A), J1.1, SW1.5
unnamed: D11.1 (K), R6.1
